niklaswa/monav-display/firmware/preview/01-boot.png

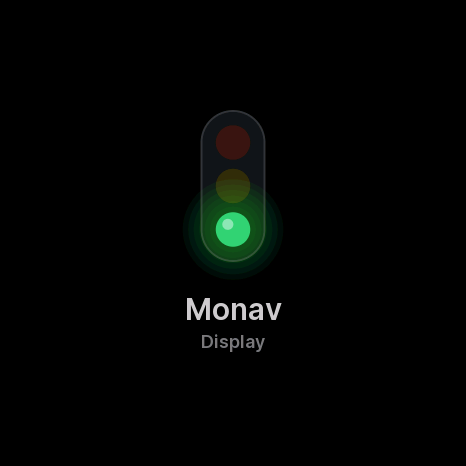
firmware/preview/01-boot.png
