niklaswa/monav-display/firmware/preview/03-waiting.png

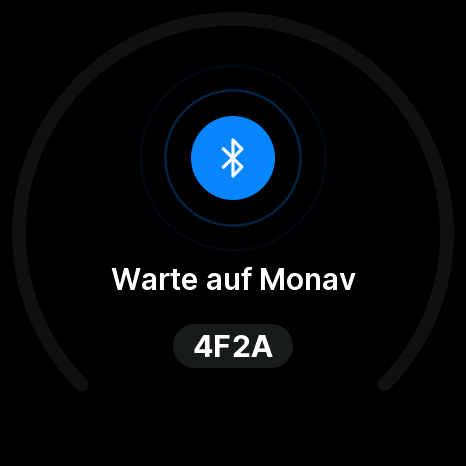
firmware/preview/03-waiting.png
