niklaswa/monav-display/firmware/preview/04-paired.png

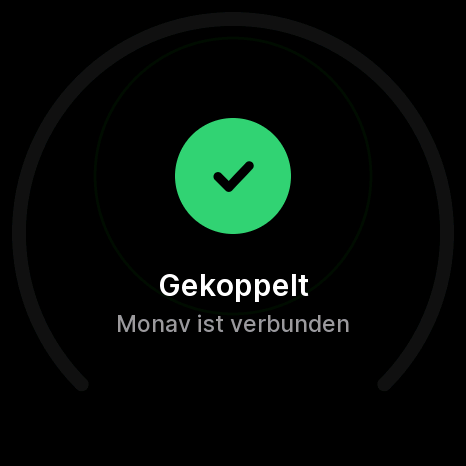
firmware/preview/04-paired.png
