niklaswa/monav-display/firmware/preview/05-denied.png

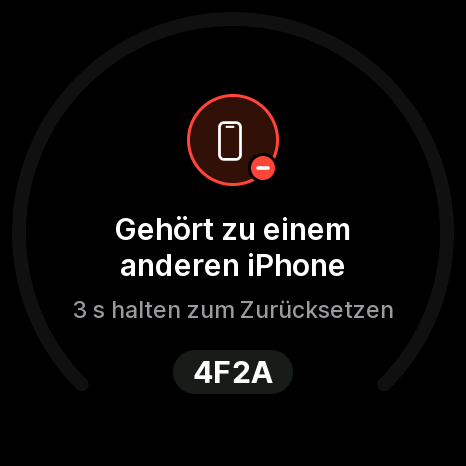
firmware/preview/05-denied.png
