niklaswa/monav-display/firmware/preview/06-connected.png

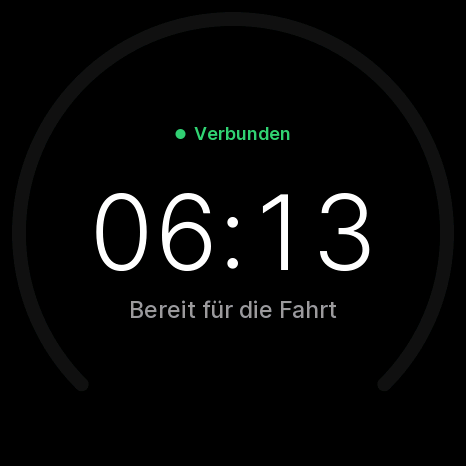
firmware/preview/06-connected.png
