niklaswa/monav-display/firmware/preview/07-camera-too-fast.png

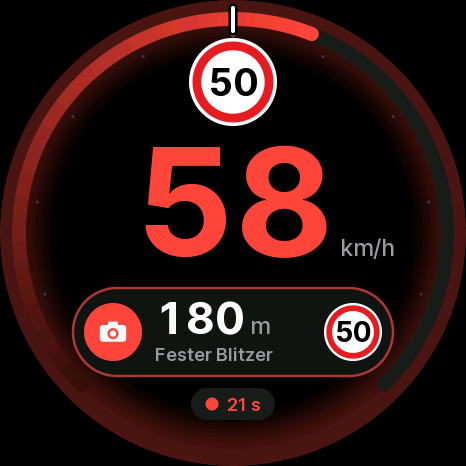
firmware/preview/07-camera-too-fast.png
