niklaswa/monav-display/firmware/preview/10-light-coast.png

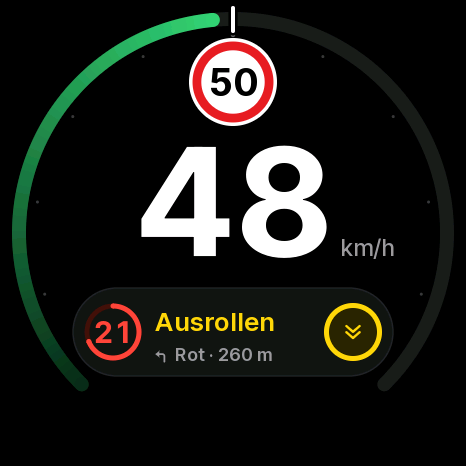
firmware/preview/10-light-coast.png
