niklaswa/monav-display/firmware/preview/11-light-standing.png

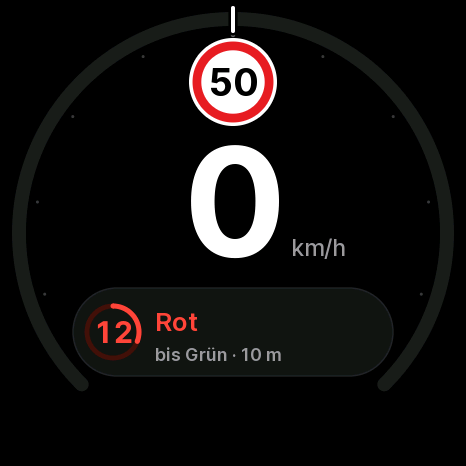
firmware/preview/11-light-standing.png
