niklaswa/monav-display/firmware/preview/12-turn.png

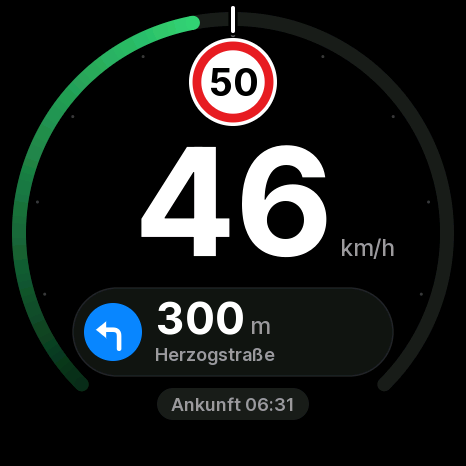
firmware/preview/12-turn.png
