niklaswa/monav-display/firmware/preview/15-highway-mobile.png

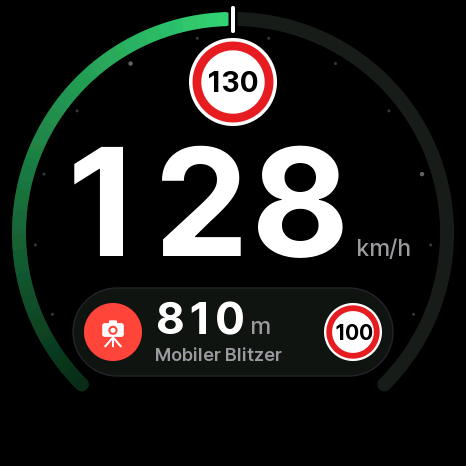
firmware/preview/15-highway-mobile.png
