niklaswa/monav-display/firmware/preview/17-no-limit.png

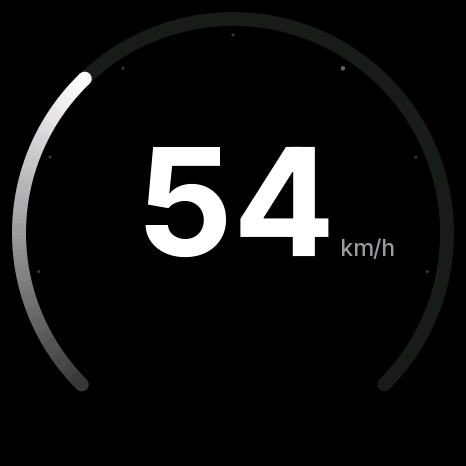
firmware/preview/17-no-limit.png
