niklaswa/monav-display/firmware/preview/18-link-lost.png

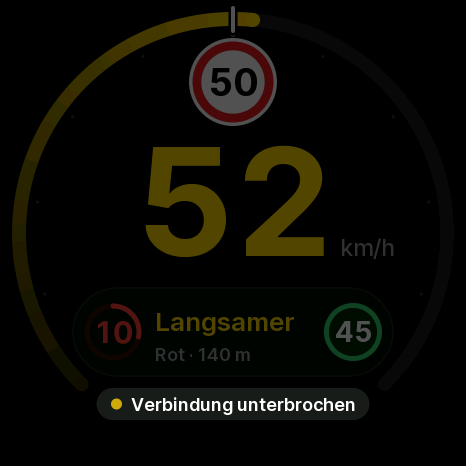
firmware/preview/18-link-lost.png
