niklaswa/monav-display/firmware/preview/20-reset-ask.png

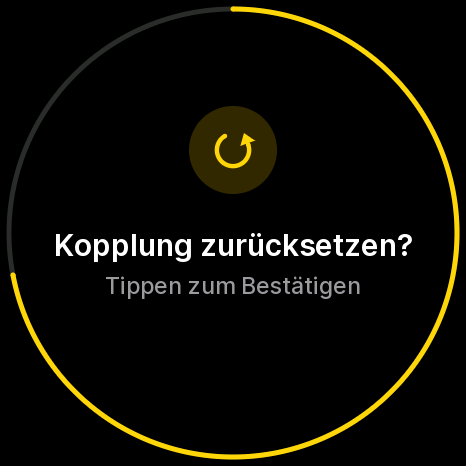
firmware/preview/20-reset-ask.png
