niklaswa/monav-display/firmware/preview/21-brightness.png

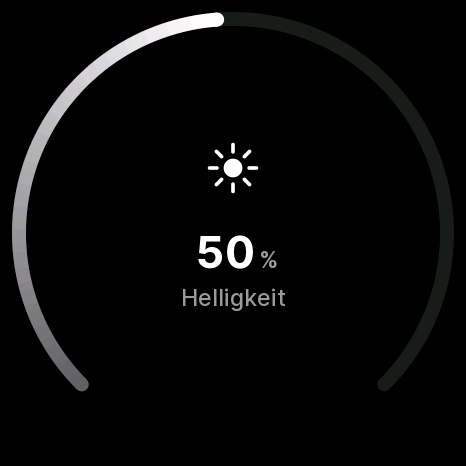
firmware/preview/21-brightness.png
