niklaswa/monav-display/firmware/preview/23-english-light.png

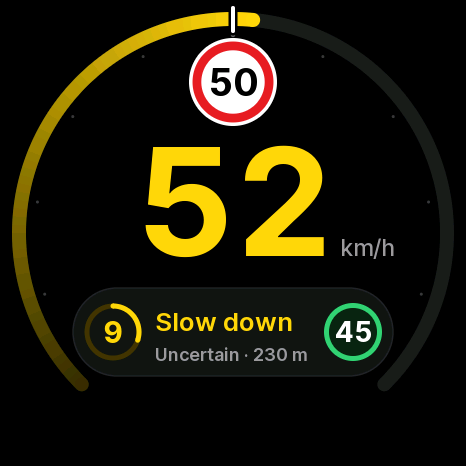
firmware/preview/23-english-light.png
