niklaswa/monav-display/firmware/preview/27-map-camera.png

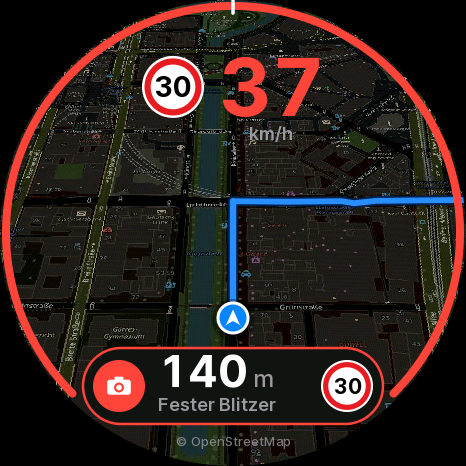
firmware/preview/27-map-camera.png
