niklaswa/monav-display/firmware/preview/29-map-english.png

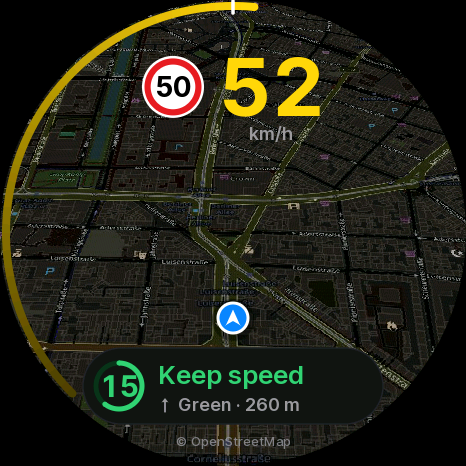
firmware/preview/29-map-english.png
