niklaswa/monav-display/firmware/preview/30-map-loading.png

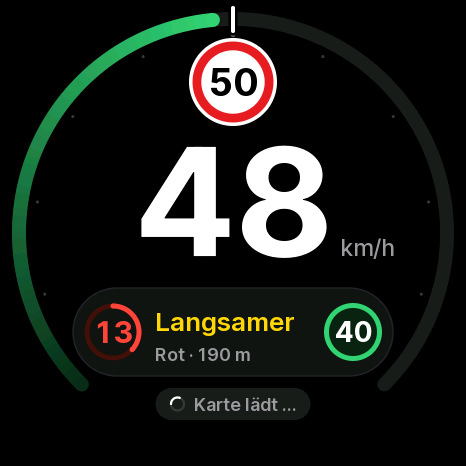
firmware/preview/30-map-loading.png
