niklaswa/monav-display/firmware/preview/32-update-restart.png

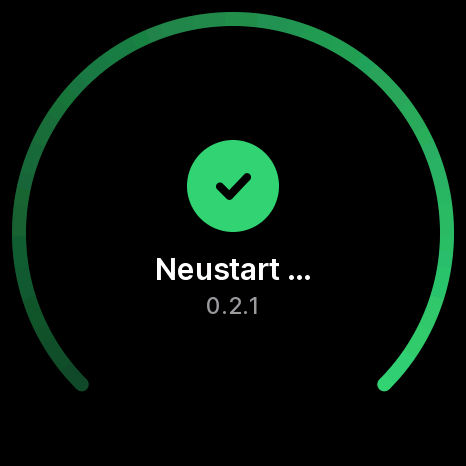
firmware/preview/32-update-restart.png
