niklaswa/monav-display/firmware/preview/33-update-failed.png

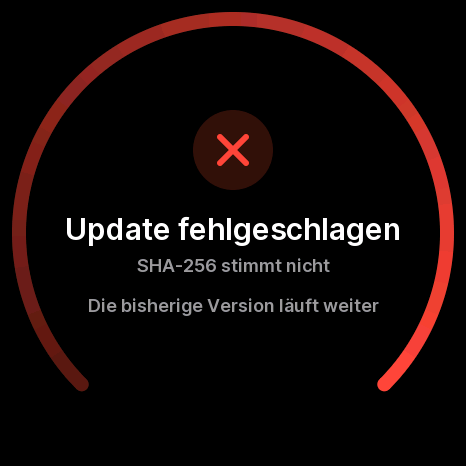
firmware/preview/33-update-failed.png
