niklaswa/monav-display/firmware/preview/34-rotated.png

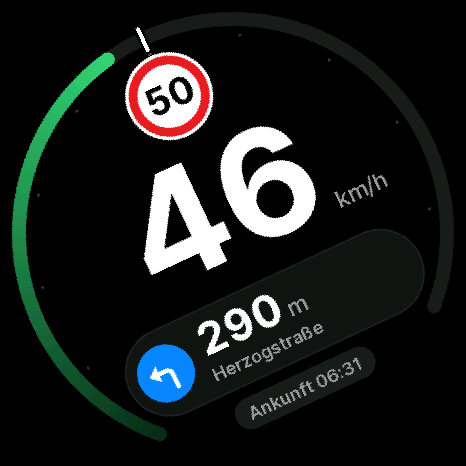
firmware/preview/34-rotated.png
