niklaswa/monav-display/firmware/preview/35-map-chargers.png

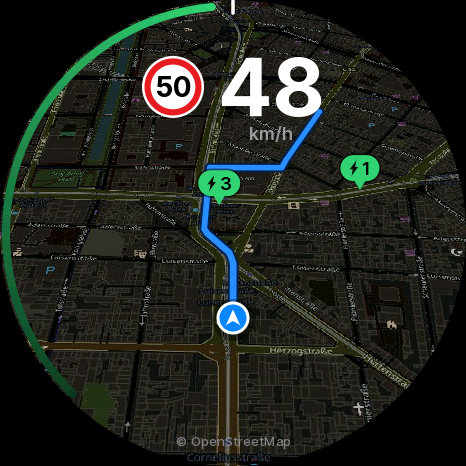
firmware/preview/35-map-chargers.png
