niklaswa/monav-display/firmware/tools/preview/maps/sample-a46.jpg

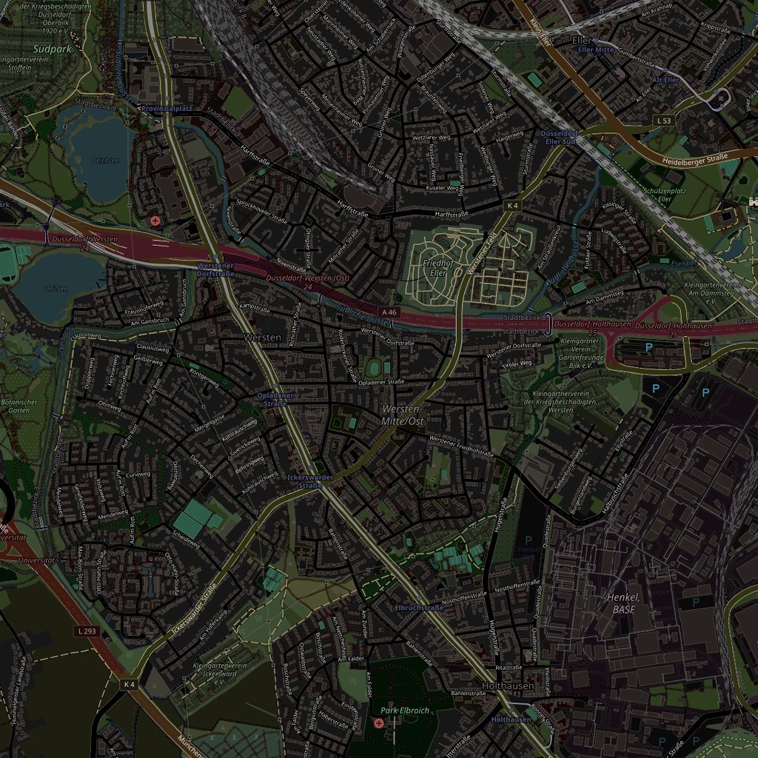
firmware/tools/preview/maps/sample-a46.jpg
