niklaswa/monav-display/firmware/tools/preview/maps/sample-berliner-allee.jpg

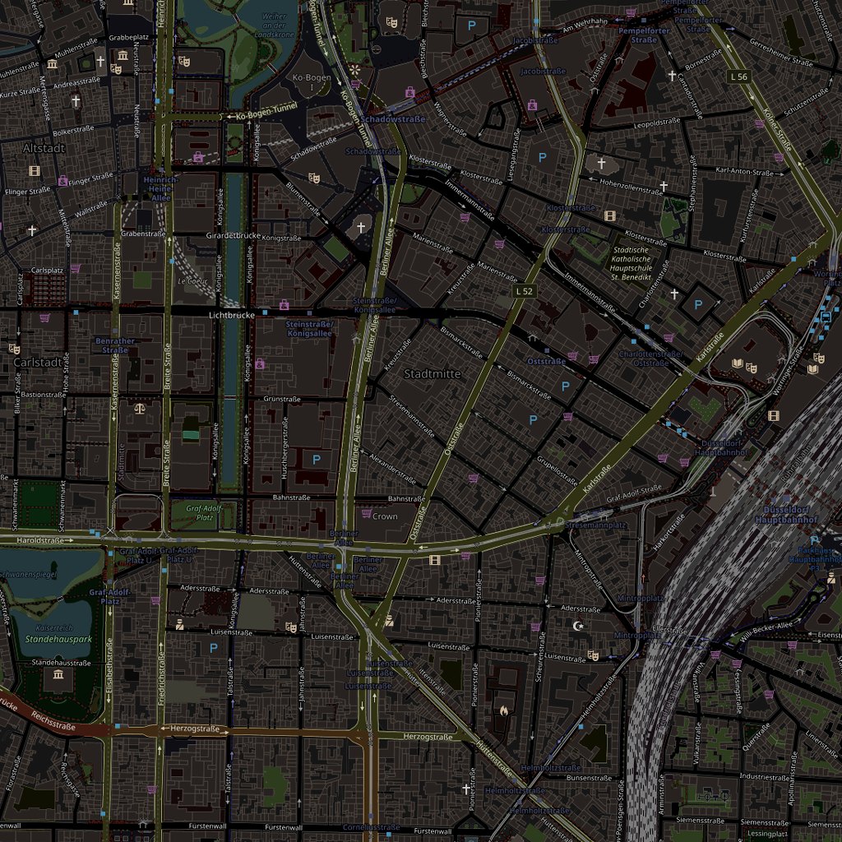
firmware/tools/preview/maps/sample-berliner-allee.jpg
