niklaswa/monav-display/firmware/tools/preview/maps/sample-koenigsallee.jpg

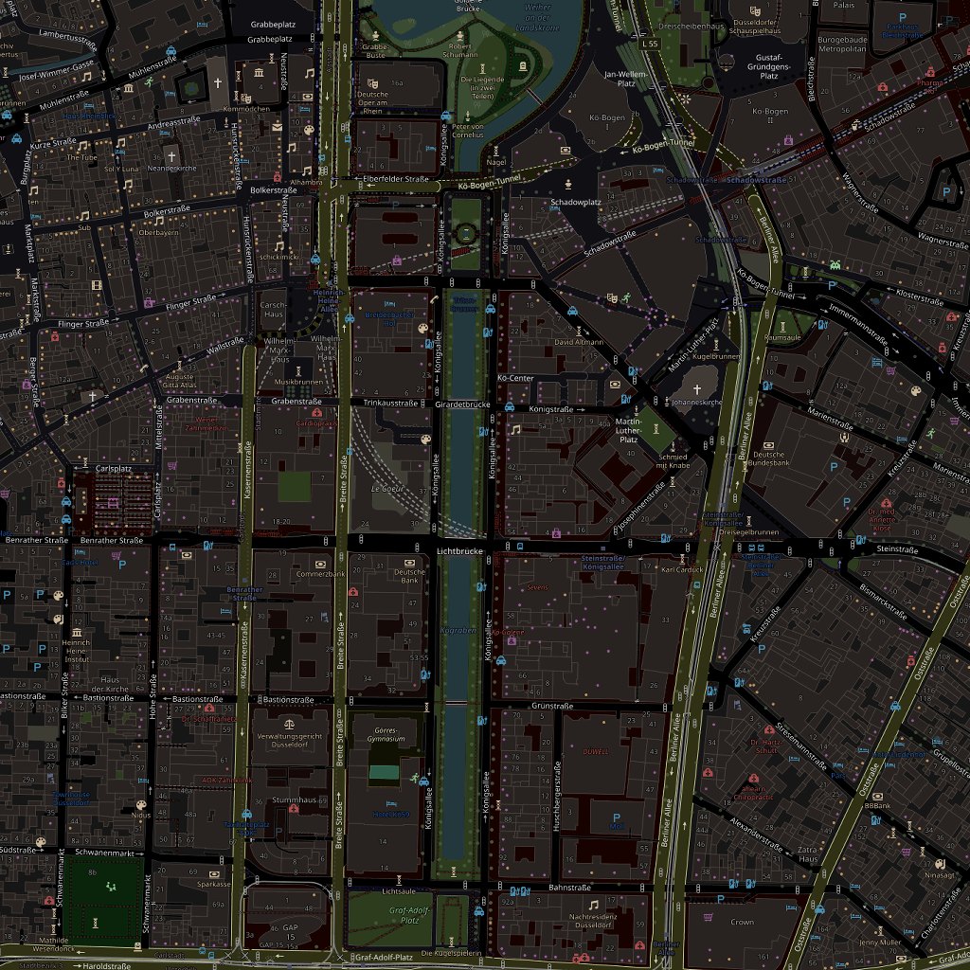
firmware/tools/preview/maps/sample-koenigsallee.jpg
