niklaswa/monav-display/mount/monav-socket.3mf

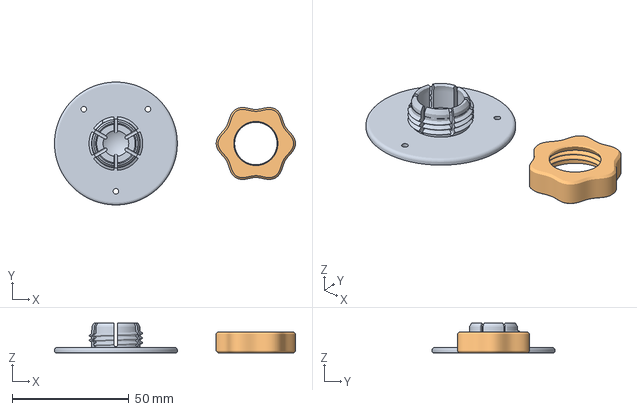
[picture p40: CAD file, 2026-11-01]
mount/monav-socket.3mf
103.3 x 52.7 x 12.8 mm
monav-lid
monav-nut
