niklaswa/monav-display/mount/monav-mount.3mf

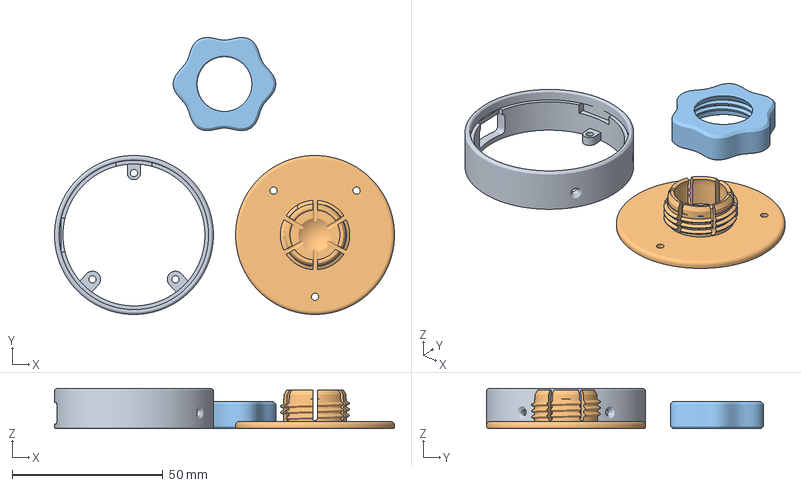
[picture p41: CAD file, 2026-11-01]
mount/monav-mount.3mf
112.7 x 91.7 x 13.4 mm
monav-ring
monav-lid
monav-nut
