niklaswa/monav-display/mount/stl/monav-ring.stl

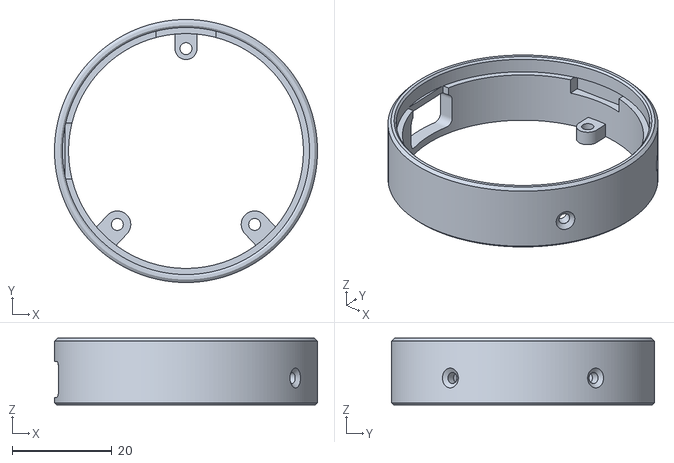
[picture p42: CAD file, 2026-11-01]
mount/stl/monav-ring.stl
52.7 x 52.7 x 13.4
