niklaswa/monav-display/mount/monav-test.3mf

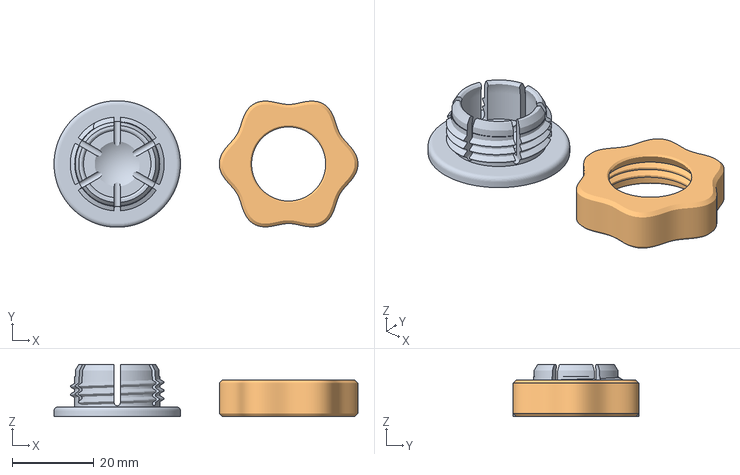
[picture p43: CAD file, 2026-11-01]
mount/monav-test.3mf
74.5 x 31.0 x 12.8 mm
monav-test_socket
monav-nut
