niklaswa/monav-display/mount/stl/monav-lid.stl

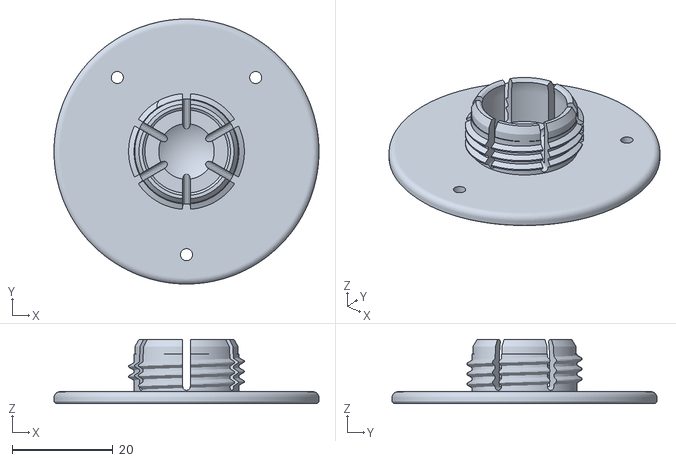
[picture p44: CAD file, 2026-11-01]
mount/stl/monav-lid.stl
52.7 x 52.7 x 12.8
