niklaswa/monav-display/mount/stl/monav-test_socket.stl

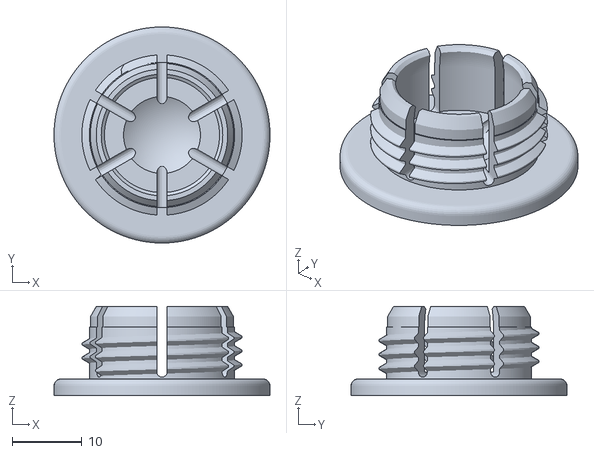
[picture p45: CAD file, 2026-11-01]
mount/stl/monav-test_socket.stl
31.0 x 31.0 x 12.8
