niklaswa/monav-display/mount/stl/monav-nut.stl

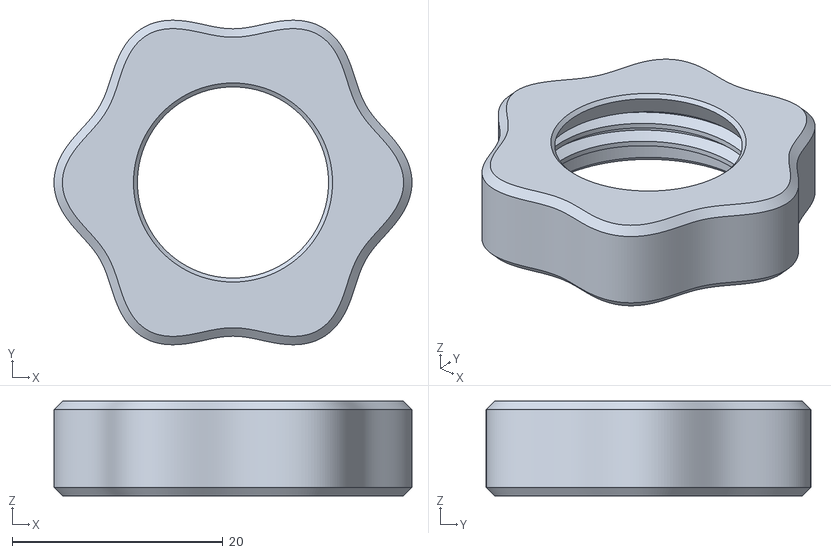
[picture p46: CAD file, 2026-11-01]
mount/stl/monav-nut.stl
34.0 x 30.8 x 9.01
