niklaswa/monav-display/mount/board_dummy.scad

// Generated from Waveshare's STEP model (ESP32-S3-Touch-AMOLED-1_75.stp): per-part bounding
// boxes in the mount's frame. X/Y as seen from behind, Z = depth behind the glass front.
// Round parts are modelled as cylinders, the two side switches as rotated boxes. Boxes are
// clipped to the PCB outline (rotated parts' boxes would poke past it), except the USB-C port,
// which really does stand 0.8 mm proud of the edge.
module board_dummy() {
    color("#111") translate([0, 0, 0]) cylinder(d = 48.96, h = 2.05);          // cover glass + panel
    color("#333") translate([0, 0, 2.05]) cylinder(d = 41.8, h = 1.35);        // panel back
    color("#c07020") intersection() { cylinder(r = 24.55, h = 3); translate([-4.65, -24.55, 2.05]) cube([9.3, 1.75, 0.70]); }  // panel flex cable folding round the edge
    color("#c07020") translate([-3.65, 23.3, 2.05]) cube([7.3, 0.7, 0.15]);     // panel tabs
    color("#ccc", 0.6) translate([0, 0, 2.05]) cylinder(d = 45.66, h = 3.65);  // PMMA spacer
    color("#1d4fa0") translate([0, 0, 5.70]) cylinder(d = 46.02, h = 1.20);    // PCB
    for (a = [33.6, -33.6]) rotate(a) {                                           // KEY1 (BOOT, +) / KEY2 (PWR, -)
        color("#888") translate([19.1, -2.3, 6.5]) cube([2.9, 4.6, 2.2]);
        color("#eee") translate([22.0, -0.9, 7.3]) cube([0.8, 2.0, 1.0]);
    }
    color("#444") intersection() { cylinder(r = 23.01, h = 20); translate([2.670, -20.120, 6.900]) cube([7.650, 4.200, 4.800]); }  // H3_ASM
    color("#444") intersection() { cylinder(r = 23.01, h = 20); translate([14.060, -7.630, 6.900]) cube([0.300, 0.490, 0.310]); }  // USER_LIBRARY-0201_0603M__CAP_ASM
    color("#444") intersection() { cylinder(r = 23.01, h = 20); translate([14.060, -7.690, 6.900]) cube([0.300, 0.060, 0.300]); }  // USER_LIBRARY-0201_0603M__CAP_ASM
    color("#444") intersection() { cylinder(r = 23.01, h = 20); translate([14.060, -7.140, 6.900]) cube([0.300, 0.060, 0.300]); }  // USER_LIBRARY-0201_0603M__CAP_ASM
    color("#444") intersection() { cylinder(r = 23.01, h = 20); translate([14.960, -7.630, 6.900]) cube([0.300, 0.490, 0.310]); }  // USER_LIBRARY-0201_0603M__CAP_ASM
    color("#444") intersection() { cylinder(r = 23.01, h = 20); translate([14.960, -7.690, 6.900]) cube([0.300, 0.060, 0.300]); }  // USER_LIBRARY-0201_0603M__CAP_ASM
    color("#444") intersection() { cylinder(r = 23.01, h = 20); translate([14.960, -7.140, 6.900]) cube([0.300, 0.060, 0.300]); }  // USER_LIBRARY-0201_0603M__CAP_ASM
    color("#444") intersection() { cylinder(r = 23.01, h = 20); translate([8.860, 2.920, 6.900]) cube([0.300, 0.480, 0.310]); }  // USER_LIBRARY-0201_0603M__CAP_ASM
    color("#444") intersection() { cylinder(r = 23.01, h = 20); translate([8.860, 3.400, 6.900]) cube([0.300, 0.060, 0.300]); }  // USER_LIBRARY-0201_0603M__CAP_ASM
    color("#444") intersection() { cylinder(r = 23.01, h = 20); translate([8.860, 2.860, 6.900]) cube([0.300, 0.060, 0.300]); }  // USER_LIBRARY-0201_0603M__CAP_ASM
    color("#444") intersection() { cylinder(r = 23.01, h = 20); translate([15.450, -4.800, 6.900]) cube([0.300, 0.490, 0.310]); }  // USER_LIBRARY-0201_0603M__CAP_ASM
    color("#444") intersection() { cylinder(r = 23.01, h = 20); translate([15.450, -4.860, 6.900]) cube([0.300, 0.060, 0.300]); }  // USER_LIBRARY-0201_0603M__CAP_ASM
    color("#444") intersection() { cylinder(r = 23.01, h = 20); translate([15.450, -4.310, 6.900]) cube([0.300, 0.060, 0.300]); }  // USER_LIBRARY-0201_0603M__CAP_ASM
    color("#444") intersection() { cylinder(r = 23.01, h = 20); translate([12.910, -4.800, 6.900]) cube([0.300, 0.490, 0.310]); }  // USER_LIBRARY-0201_0603M__CAP_ASM
    color("#444") intersection() { cylinder(r = 23.01, h = 20); translate([12.910, -4.860, 6.900]) cube([0.300, 0.060, 0.300]); }  // USER_LIBRARY-0201_0603M__CAP_ASM
    color("#444") intersection() { cylinder(r = 23.01, h = 20); translate([12.910, -4.310, 6.900]) cube([0.300, 0.060, 0.300]); }  // USER_LIBRARY-0201_0603M__CAP_ASM
    color("#444") intersection() { cylinder(r = 23.01, h = 20); translate([14.090, -9.540, 6.900]) cube([0.300, 0.490, 0.310]); }  // USER_LIBRARY-0201_0603M__CAP_ASM
    color("#444") intersection() { cylinder(r = 23.01, h = 20); translate([14.090, -9.600, 6.900]) cube([0.300, 0.060, 0.300]); }  // USER_LIBRARY-0201_0603M__CAP_ASM
    color("#444") intersection() { cylinder(r = 23.01, h = 20); translate([14.090, -9.050, 6.900]) cube([0.300, 0.060, 0.300]); }  // USER_LIBRARY-0201_0603M__CAP_ASM
    color("#444") intersection() { cylinder(r = 23.01, h = 20); translate([16.590, -6.320, 6.900]) cube([0.300, 0.480, 0.310]); }  // USER_LIBRARY-0201_0603M__CAP_ASM
    color("#444") intersection() { cylinder(r = 23.01, h = 20); translate([16.590, -6.380, 6.900]) cube([0.300, 0.060, 0.300]); }  // USER_LIBRARY-0201_0603M__CAP_ASM
    color("#444") intersection() { cylinder(r = 23.01, h = 20); translate([16.590, -5.840, 6.900]) cube([0.300, 0.070, 0.300]); }  // USER_LIBRARY-0201_0603M__CAP_ASM
    color("#444") intersection() { cylinder(r = 23.01, h = 20); translate([9.520, -9.540, 6.900]) cube([0.310, 0.490, 0.310]); }  // USER_LIBRARY-0201_0603M__CAP_ASM
    color("#444") intersection() { cylinder(r = 23.01, h = 20); translate([9.520, -9.600, 6.900]) cube([0.310, 0.060, 0.300]); }  // USER_LIBRARY-0201_0603M__CAP_ASM
    color("#444") intersection() { cylinder(r = 23.01, h = 20); translate([9.520, -9.050, 6.900]) cube([0.310, 0.060, 0.300]); }  // USER_LIBRARY-0201_0603M__CAP_ASM
    color("#444") intersection() { cylinder(r = 23.01, h = 20); translate([7.760, -9.540, 6.900]) cube([0.300, 0.490, 0.310]); }  // USER_LIBRARY-0201_0603M__CAP_ASM
    color("#444") intersection() { cylinder(r = 23.01, h = 20); translate([7.760, -9.600, 6.900]) cube([0.300, 0.060, 0.300]); }  // USER_LIBRARY-0201_0603M__CAP_ASM
    color("#444") intersection() { cylinder(r = 23.01, h = 20); translate([7.760, -9.050, 6.900]) cube([0.300, 0.060, 0.300]); }  // USER_LIBRARY-0201_0603M__CAP_ASM
    color("#444") intersection() { cylinder(r = 23.01, h = 20); translate([14.220, 7.880, 6.900]) cube([0.480, 0.300, 0.310]); }  // USER_LIBRARY-0201_0603M__CAP_ASM
    color("#444") intersection() { cylinder(r = 23.01, h = 20); translate([14.160, 7.880, 6.900]) cube([0.060, 0.300, 0.300]); }  // USER_LIBRARY-0201_0603M__CAP_ASM
    color("#444") intersection() { cylinder(r = 23.01, h = 20); translate([14.700, 7.880, 6.900]) cube([0.070, 0.300, 0.300]); }  // USER_LIBRARY-0201_0603M__CAP_ASM
    color("#444") intersection() { cylinder(r = 23.01, h = 20); translate([12.290, 7.880, 6.900]) cube([0.480, 0.300, 0.310]); }  // USER_LIBRARY-0201_0603M__CAP_ASM
    color("#444") intersection() { cylinder(r = 23.01, h = 20); translate([12.770, 7.880, 6.900]) cube([0.070, 0.300, 0.300]); }  // USER_LIBRARY-0201_0603M__CAP_ASM
    color("#444") intersection() { cylinder(r = 23.01, h = 20); translate([12.230, 7.880, 6.900]) cube([0.060, 0.300, 0.300]); }  // USER_LIBRARY-0201_0603M__CAP_ASM
    color("#444") intersection() { cylinder(r = 23.01, h = 20); translate([14.090, 0.770, 6.900]) cube([0.480, 0.310, 0.310]); }  // USER_LIBRARY-0201_0603M__CAP_ASM
    color("#444") intersection() { cylinder(r = 23.01, h = 20); translate([14.570, 0.770, 6.900]) cube([0.070, 0.310, 0.300]); }  // USER_LIBRARY-0201_0603M__CAP_ASM
    color("#444") intersection() { cylinder(r = 23.01, h = 20); translate([14.030, 0.770, 6.900]) cube([0.060, 0.310, 0.300]); }  // USER_LIBRARY-0201_0603M__CAP_ASM
    color("#444") intersection() { cylinder(r = 23.01, h = 20); translate([8.590, -9.540, 6.900]) cube([0.300, 0.490, 0.310]); }  // USER_LIBRARY-0201_0603M__CAP_ASM
    color("#444") intersection() { cylinder(r = 23.01, h = 20); translate([8.590, -9.050, 6.900]) cube([0.300, 0.060, 0.300]); }  // USER_LIBRARY-0201_0603M__CAP_ASM
    color("#444") intersection() { cylinder(r = 23.01, h = 20); translate([8.590, -9.600, 6.900]) cube([0.300, 0.060, 0.300]); }  // USER_LIBRARY-0201_0603M__CAP_ASM
    color("#444") intersection() { cylinder(r = 23.01, h = 20); translate([14.090, -0.060, 6.900]) cube([0.480, 0.300, 0.310]); }  // USER_LIBRARY-0201_0603M__CAP_ASM
    color("#444") intersection() { cylinder(r = 23.01, h = 20); translate([14.570, -0.060, 6.900]) cube([0.070, 0.300, 0.300]); }  // USER_LIBRARY-0201_0603M__CAP_ASM
    color("#444") intersection() { cylinder(r = 23.01, h = 20); translate([14.030, -0.060, 6.900]) cube([0.060, 0.300, 0.300]); }  // USER_LIBRARY-0201_0603M__CAP_ASM
    color("#444") intersection() { cylinder(r = 23.01, h = 20); translate([14.030, -1.110, 6.930]) cube([0.600, 0.500, 0.500]); }  // _1_10001
    color("#444") intersection() { cylinder(r = 23.01, h = 20); translate([12.960, -2.550, 6.920]) cube([2.390, 2.600, 0.520]); }  // C_0402-672_AF0_ASM_ASM
    color("#444") intersection() { cylinder(r = 23.01, h = 20); translate([14.630, -1.120, 6.920]) cube([0.200, 0.520, 0.520]); }  // 2_100
    color("#444") intersection() { cylinder(r = 23.01, h = 20); translate([14.090, -3.160, 6.900]) cube([0.490, 0.300, 0.310]); }  // USER_LIBRARY-0201_0603M__CAP_ASM
    color("#444") intersection() { cylinder(r = 23.01, h = 20); translate([14.030, -3.160, 6.900]) cube([0.060, 0.300, 0.300]); }  // USER_LIBRARY-0201_0603M__CAP_ASM
    color("#444") intersection() { cylinder(r = 23.01, h = 20); translate([14.580, -3.160, 6.900]) cube([0.060, 0.300, 0.300]); }  // USER_LIBRARY-0201_0603M__CAP_ASM
    color("#444") intersection() { cylinder(r = 23.01, h = 20); translate([14.220, 9.550, 6.900]) cube([0.480, 0.310, 0.310]); }  // USER_LIBRARY-0201_0603M__CAP_ASM
    color("#444") intersection() { cylinder(r = 23.01, h = 20); translate([14.160, 9.550, 6.900]) cube([0.060, 0.310, 0.300]); }  // USER_LIBRARY-0201_0603M__CAP_ASM
    color("#444") intersection() { cylinder(r = 23.01, h = 20); translate([14.700, 9.550, 6.900]) cube([0.070, 0.310, 0.300]); }  // USER_LIBRARY-0201_0603M__CAP_ASM
    color("#444") intersection() { cylinder(r = 23.01, h = 20); translate([10.680, 12.280, 6.900]) cube([0.300, 0.490, 0.310]); }  // USER_LIBRARY-0201_0603M__CAP_ASM
    color("#444") intersection() { cylinder(r = 23.01, h = 20); translate([10.680, 12.770, 6.900]) cube([0.300, 0.060, 0.300]); }  // USER_LIBRARY-0201_0603M__CAP_ASM
    color("#444") intersection() { cylinder(r = 23.01, h = 20); translate([10.680, 12.220, 6.900]) cube([0.300, 0.060, 0.300]); }  // USER_LIBRARY-0201_0603M__CAP_ASM
    color("#444") intersection() { cylinder(r = 23.01, h = 20); translate([10.670, 13.630, 6.900]) cube([0.310, 0.490, 0.310]); }  // USER_LIBRARY-0201_0603M__CAP_ASM
    color("#444") intersection() { cylinder(r = 23.01, h = 20); translate([10.680, 13.570, 6.900]) cube([0.300, 0.060, 0.300]); }  // USER_LIBRARY-0201_0603M__CAP_ASM
    color("#444") intersection() { cylinder(r = 23.01, h = 20); translate([10.670, 14.120, 6.900]) cube([0.310, 0.060, 0.300]); }  // USER_LIBRARY-0201_0603M__CAP_ASM
    color("#444") intersection() { cylinder(r = 23.01, h = 20); translate([-8.720, 11.350, 6.900]) cube([0.300, 0.490, 0.310]); }  // USER_LIBRARY-0201_0603M__CAP_ASM
    color("#444") intersection() { cylinder(r = 23.01, h = 20); translate([-8.720, 11.290, 6.900]) cube([0.300, 0.060, 0.300]); }  // USER_LIBRARY-0201_0603M__CAP_ASM
    color("#444") intersection() { cylinder(r = 23.01, h = 20); translate([-8.720, 11.840, 6.900]) cube([0.300, 0.060, 0.300]); }  // USER_LIBRARY-0201_0603M__CAP_ASM
    color("#444") intersection() { cylinder(r = 23.01, h = 20); translate([-5.950, 13.290, 6.900]) cube([0.490, 0.310, 0.310]); }  // USER_LIBRARY-0201_0603M__CAP_ASM
    color("#444") intersection() { cylinder(r = 23.01, h = 20); translate([-5.460, 13.290, 6.900]) cube([0.060, 0.310, 0.300]); }  // USER_LIBRARY-0201_0603M__CAP_ASM
    color("#444") intersection() { cylinder(r = 23.01, h = 20); translate([-6.010, 13.290, 6.900]) cube([0.060, 0.310, 0.300]); }  // USER_LIBRARY-0201_0603M__CAP_ASM
    color("#444") intersection() { cylinder(r = 23.01, h = 20); translate([-4.530, 13.290, 6.900]) cube([0.490, 0.310, 0.310]); }  // USER_LIBRARY-0201_0603M__CAP_ASM
    color("#444") intersection() { cylinder(r = 23.01, h = 20); translate([-4.590, 13.290, 6.900]) cube([0.060, 0.310, 0.300]); }  // USER_LIBRARY-0201_0603M__CAP_ASM
    color("#444") intersection() { cylinder(r = 23.01, h = 20); translate([-4.040, 13.290, 6.900]) cube([0.060, 0.310, 0.300]); }  // USER_LIBRARY-0201_0603M__CAP_ASM
    color("#444") intersection() { cylinder(r = 23.01, h = 20); translate([-5.100, 11.170, 6.900]) cube([0.490, 0.300, 0.310]); }  // USER_LIBRARY-0201_0603M__CAP_ASM
    color("#444") intersection() { cylinder(r = 23.01, h = 20); translate([-4.610, 11.170, 6.900]) cube([0.060, 0.300, 0.300]); }  // USER_LIBRARY-0201_0603M__CAP_ASM
    color("#444") intersection() { cylinder(r = 23.01, h = 20); translate([-5.160, 11.170, 6.900]) cube([0.060, 0.300, 0.300]); }  // USER_LIBRARY-0201_0603M__CAP_ASM
    color("#444") intersection() { cylinder(r = 23.01, h = 20); translate([-18.680, 6.260, 6.900]) cube([0.310, 0.490, 0.310]); }  // USER_LIBRARY-0201_0603M__CAP_ASM
    color("#444") intersection() { cylinder(r = 23.01, h = 20); translate([-18.680, 6.200, 6.900]) cube([0.310, 0.060, 0.300]); }  // USER_LIBRARY-0201_0603M__CAP_ASM
    color("#444") intersection() { cylinder(r = 23.01, h = 20); translate([-18.680, 6.750, 6.900]) cube([0.310, 0.060, 0.300]); }  // USER_LIBRARY-0201_0603M__CAP_ASM
    color("#444") intersection() { cylinder(r = 23.01, h = 20); translate([-18.670, 7.570, 6.900]) cube([0.300, 0.490, 0.310]); }  // USER_LIBRARY-0201_0603M__CAP_ASM
    color("#444") intersection() { cylinder(r = 23.01, h = 20); translate([-18.670, 7.510, 6.900]) cube([0.300, 0.060, 0.300]); }  // USER_LIBRARY-0201_0603M__CAP_ASM
    color("#444") intersection() { cylinder(r = 23.01, h = 20); translate([-18.670, 8.060, 6.900]) cube([0.300, 0.060, 0.300]); }  // USER_LIBRARY-0201_0603M__CAP_ASM
    color("#444") intersection() { cylinder(r = 23.01, h = 20); translate([2.040, -13.040, 6.930]) cube([0.600, 0.500, 0.500]); }  // _1_10001
    color("#444") intersection() { cylinder(r = 23.01, h = 20); translate([1.320, -13.700, 6.920]) cube([2.390, 2.600, 0.520]); }  // C_0402-672_AF0_ASM_ASM
    color("#444") intersection() { cylinder(r = 23.01, h = 20); translate([1.840, -13.050, 6.920]) cube([0.200, 0.520, 0.520]); }  // 2_100
    color("#444") intersection() { cylinder(r = 23.01, h = 20); translate([0.580, -8.310, 6.900]) cube([0.480, 0.300, 0.310]); }  // USER_LIBRARY-0201_0603M__CAP_ASM
    color("#444") intersection() { cylinder(r = 23.01, h = 20); translate([1.060, -8.310, 6.900]) cube([0.060, 0.300, 0.300]); }  // USER_LIBRARY-0201_0603M__CAP_ASM
    color("#444") intersection() { cylinder(r = 23.01, h = 20); translate([0.510, -8.310, 6.900]) cube([0.070, 0.300, 0.300]); }  // USER_LIBRARY-0201_0603M__CAP_ASM
    color("#444") intersection() { cylinder(r = 23.01, h = 20); translate([0.950, -9.520, 6.900]) cube([0.310, 0.480, 0.310]); }  // USER_LIBRARY-0201_0603M__CAP_ASM
    color("#444") intersection() { cylinder(r = 23.01, h = 20); translate([0.950, -9.040, 6.900]) cube([0.310, 0.060, 0.300]); }  // USER_LIBRARY-0201_0603M__CAP_ASM
    color("#444") intersection() { cylinder(r = 23.01, h = 20); translate([0.950, -9.590, 6.900]) cube([0.310, 0.070, 0.300]); }  // USER_LIBRARY-0201_0603M__CAP_ASM
    color("#444") intersection() { cylinder(r = 23.01, h = 20); translate([-0.300, -17.600, 6.930]) cube([0.600, 0.500, 0.500]); }  // _1_10001
    color("#444") intersection() { cylinder(r = 23.01, h = 20); translate([-1.020, -18.260, 6.920]) cube([2.390, 2.600, 0.520]); }  // C_0402-672_AF0_ASM_ASM
    color("#444") intersection() { cylinder(r = 23.01, h = 20); translate([-0.500, -17.610, 6.920]) cube([0.200, 0.520, 0.520]); }  // 2_100
    color("#444") intersection() { cylinder(r = 23.01, h = 20); translate([-3.040, -13.040, 6.930]) cube([0.600, 0.500, 0.500]); }  // _1_10001
    color("#444") intersection() { cylinder(r = 23.01, h = 20); translate([-3.760, -13.700, 6.920]) cube([2.390, 2.600, 0.520]); }  // C_0402-672_AF0_ASM_ASM
    color("#444") intersection() { cylinder(r = 23.01, h = 20); translate([-3.240, -13.050, 6.920]) cube([0.200, 0.520, 0.520]); }  // 2_100
    color("#444") intersection() { cylinder(r = 23.01, h = 20); translate([-0.770, -8.310, 6.900]) cube([0.490, 0.300, 0.310]); }  // USER_LIBRARY-0201_0603M__CAP_ASM
    color("#444") intersection() { cylinder(r = 23.01, h = 20); translate([-0.280, -8.310, 6.900]) cube([0.060, 0.300, 0.300]); }  // USER_LIBRARY-0201_0603M__CAP_ASM
    color("#444") intersection() { cylinder(r = 23.01, h = 20); translate([-0.830, -8.310, 6.900]) cube([0.060, 0.300, 0.300]); }  // USER_LIBRARY-0201_0603M__CAP_ASM
    color("#444") intersection() { cylinder(r = 23.01, h = 20); translate([-0.680, -9.480, 6.900]) cube([0.310, 0.480, 0.310]); }  // USER_LIBRARY-0201_0603M__CAP_ASM
    color("#444") intersection() { cylinder(r = 23.01, h = 20); translate([-0.680, -9.000, 6.900]) cube([0.310, 0.060, 0.300]); }  // USER_LIBRARY-0201_0603M__CAP_ASM
    color("#444") intersection() { cylinder(r = 23.01, h = 20); translate([-0.680, -9.550, 6.900]) cube([0.310, 0.070, 0.300]); }  // USER_LIBRARY-0201_0603M__CAP_ASM
    color("#444") intersection() { cylinder(r = 23.01, h = 20); translate([-14.110, -7.770, 6.900]) cube([0.310, 0.490, 0.310]); }  // USER_LIBRARY-0201_0603M__CAP_ASM
    color("#444") intersection() { cylinder(r = 23.01, h = 20); translate([-14.110, -7.280, 6.900]) cube([0.310, 0.060, 0.300]); }  // USER_LIBRARY-0201_0603M__CAP_ASM
    color("#444") intersection() { cylinder(r = 23.01, h = 20); translate([-14.110, -7.830, 6.900]) cube([0.310, 0.060, 0.300]); }  // USER_LIBRARY-0201_0603M__CAP_ASM
    color("#444") intersection() { cylinder(r = 23.01, h = 20); translate([-14.110, -6.270, 6.900]) cube([0.300, 0.490, 0.310]); }  // USER_LIBRARY-0201_0603M__CAP_ASM
    color("#444") intersection() { cylinder(r = 23.01, h = 20); translate([-14.110, -5.780, 6.900]) cube([0.300, 0.060, 0.300]); }  // USER_LIBRARY-0201_0603M__CAP_ASM
    color("#444") intersection() { cylinder(r = 23.01, h = 20); translate([-14.110, -6.330, 6.900]) cube([0.300, 0.060, 0.300]); }  // USER_LIBRARY-0201_0603M__CAP_ASM
    color("#444") intersection() { cylinder(r = 23.01, h = 20); translate([-14.930, -6.270, 6.900]) cube([0.310, 0.490, 0.310]); }  // USER_LIBRARY-0201_0603M__CAP_ASM
    color("#444") intersection() { cylinder(r = 23.01, h = 20); translate([-14.930, -5.780, 6.900]) cube([0.310, 0.060, 0.300]); }  // USER_LIBRARY-0201_0603M__CAP_ASM
    color("#444") intersection() { cylinder(r = 23.01, h = 20); translate([-14.930, -6.330, 6.900]) cube([0.310, 0.060, 0.300]); }  // USER_LIBRARY-0201_0603M__CAP_ASM
    color("#444") intersection() { cylinder(r = 23.01, h = 20); translate([-16.560, -7.770, 6.900]) cube([0.310, 0.490, 0.310]); }  // USER_LIBRARY-0201_0603M__CAP_ASM
    color("#444") intersection() { cylinder(r = 23.01, h = 20); translate([-16.560, -7.280, 6.900]) cube([0.310, 0.060, 0.300]); }  // USER_LIBRARY-0201_0603M__CAP_ASM
    color("#444") intersection() { cylinder(r = 23.01, h = 20); translate([-16.550, -7.830, 6.900]) cube([0.300, 0.060, 0.300]); }  // USER_LIBRARY-0201_0603M__CAP_ASM
    color("#444") intersection() { cylinder(r = 23.01, h = 20); translate([-14.920, -7.770, 6.900]) cube([0.300, 0.490, 0.310]); }  // USER_LIBRARY-0201_0603M__CAP_ASM
    color("#444") intersection() { cylinder(r = 23.01, h = 20); translate([-14.920, -7.830, 6.900]) cube([0.300, 0.060, 0.300]); }  // USER_LIBRARY-0201_0603M__CAP_ASM
    color("#444") intersection() { cylinder(r = 23.01, h = 20); translate([-14.920, -7.280, 6.900]) cube([0.300, 0.060, 0.300]); }  // USER_LIBRARY-0201_0603M__CAP_ASM
    color("#444") intersection() { cylinder(r = 23.01, h = 20); translate([1.950, -9.540, 6.900]) cube([0.310, 0.490, 0.310]); }  // USER_LIBRARY-0201_0603M__CAP_ASM
    color("#444") intersection() { cylinder(r = 23.01, h = 20); translate([1.950, -9.600, 6.900]) cube([0.310, 0.060, 0.300]); }  // USER_LIBRARY-0201_0603M__CAP_ASM
    color("#444") intersection() { cylinder(r = 23.01, h = 20); translate([1.950, -9.050, 6.900]) cube([0.310, 0.060, 0.300]); }  // USER_LIBRARY-0201_0603M__CAP_ASM
    color("#444") intersection() { cylinder(r = 23.01, h = 20); translate([-12.480, -6.270, 6.900]) cube([0.310, 0.490, 0.310]); }  // USER_LIBRARY-0201_0603M__CAP_ASM
    color("#444") intersection() { cylinder(r = 23.01, h = 20); translate([-12.480, -5.780, 6.900]) cube([0.310, 0.060, 0.300]); }  // USER_LIBRARY-0201_0603M__CAP_ASM
    color("#444") intersection() { cylinder(r = 23.01, h = 20); translate([-12.480, -6.330, 6.900]) cube([0.310, 0.060, 0.300]); }  // USER_LIBRARY-0201_0603M__CAP_ASM
    color("#444") intersection() { cylinder(r = 23.01, h = 20); translate([-13.290, -6.270, 6.900]) cube([0.300, 0.490, 0.310]); }  // USER_LIBRARY-0201_0603M__CAP_ASM
    color("#444") intersection() { cylinder(r = 23.01, h = 20); translate([-13.290, -5.780, 6.900]) cube([0.300, 0.060, 0.300]); }  // USER_LIBRARY-0201_0603M__CAP_ASM
    color("#444") intersection() { cylinder(r = 23.01, h = 20); translate([-13.290, -6.330, 6.900]) cube([0.300, 0.060, 0.300]); }  // USER_LIBRARY-0201_0603M__CAP_ASM
    color("#444") intersection() { cylinder(r = 23.01, h = 20); translate([-12.470, -7.770, 6.900]) cube([0.300, 0.490, 0.310]); }  // USER_LIBRARY-0201_0603M__CAP_ASM
    color("#444") intersection() { cylinder(r = 23.01, h = 20); translate([-12.470, -7.280, 6.900]) cube([0.300, 0.060, 0.300]); }  // USER_LIBRARY-0201_0603M__CAP_ASM
    color("#444") intersection() { cylinder(r = 23.01, h = 20); translate([-12.470, -7.830, 6.900]) cube([0.300, 0.060, 0.300]); }  // USER_LIBRARY-0201_0603M__CAP_ASM
    color("#444") intersection() { cylinder(r = 23.01, h = 20); translate([-13.290, -7.770, 6.900]) cube([0.310, 0.490, 0.310]); }  // USER_LIBRARY-0201_0603M__CAP_ASM
    color("#444") intersection() { cylinder(r = 23.01, h = 20); translate([-13.290, -7.280, 6.900]) cube([0.310, 0.060, 0.300]); }  // USER_LIBRARY-0201_0603M__CAP_ASM
    color("#444") intersection() { cylinder(r = 23.01, h = 20); translate([-13.290, -7.830, 6.900]) cube([0.310, 0.060, 0.300]); }  // USER_LIBRARY-0201_0603M__CAP_ASM
    color("#444") intersection() { cylinder(r = 23.01, h = 20); translate([-12.370, -4.460, 6.920]) cube([0.300, 0.820, 0.820]); }  // 2_1_200
    color("#444") intersection() { cylinder(r = 23.01, h = 20); translate([-13.370, -4.450, 6.930]) cube([1.000, 0.800, 0.800]); }  // _1_1_20001
    color("#444") intersection() { cylinder(r = 23.01, h = 20); translate([-15.230, -7.030, 6.920]) cube([4.180, 4.540, 0.820]); }  // C_0603-683_AF0_ASM_ASM
    color("#444") intersection() { cylinder(r = 23.01, h = 20); translate([-10.430, 7.250, 6.920]) cube([0.820, 0.300, 0.820]); }  // 2_1_200
    color("#444") intersection() { cylinder(r = 23.01, h = 20); translate([-10.420, 6.250, 6.930]) cube([0.800, 1.000, 0.800]); }  // _1_1_20001
    color("#444") intersection() { cylinder(r = 23.01, h = 20); translate([-11.580, 4.390, 6.920]) cube([4.540, 4.180, 0.820]); }  // C_0603-683_AF0_ASM_ASM
    color("#444") intersection() { cylinder(r = 23.01, h = 20); translate([-8.110, -2.860, 6.900]) cube([0.490, 0.300, 0.310]); }  // USER_LIBRARY-0201_0603M__CAP_ASM
    color("#444") intersection() { cylinder(r = 23.01, h = 20); translate([-7.620, -2.860, 6.900]) cube([0.060, 0.300, 0.300]); }  // USER_LIBRARY-0201_0603M__CAP_ASM
    color("#444") intersection() { cylinder(r = 23.01, h = 20); translate([-8.170, -2.860, 6.900]) cube([0.060, 0.300, 0.300]); }  // USER_LIBRARY-0201_0603M__CAP_ASM
    color("#444") intersection() { cylinder(r = 23.01, h = 20); translate([0.160, -3.590, 6.920]) cube([0.300, 0.820, 0.820]); }  // 2_1_200
    color("#444") intersection() { cylinder(r = 23.01, h = 20); translate([-0.840, -3.580, 6.930]) cube([1.000, 0.800, 0.800]); }  // _1_1_20001
    color("#444") intersection() { cylinder(r = 23.01, h = 20); translate([-2.700, -6.160, 6.920]) cube([4.180, 4.540, 0.820]); }  // C_0603-683_AF0_ASM_ASM
    color("#444") intersection() { cylinder(r = 23.01, h = 20); translate([-10.450, 10.010, 6.920]) cube([0.820, 0.300, 0.820]); }  // 2_1_200
    color("#444") intersection() { cylinder(r = 23.01, h = 20); translate([-10.440, 9.010, 6.930]) cube([0.800, 1.000, 0.800]); }  // _1_1_20001
    color("#444") intersection() { cylinder(r = 23.01, h = 20); translate([-11.600, 7.150, 6.920]) cube([4.540, 4.190, 0.820]); }  // C_0603-683_AF0_ASM_ASM
    color("#444") intersection() { cylinder(r = 23.01, h = 20); translate([-8.720, 9.070, 6.900]) cube([0.300, 0.490, 0.310]); }  // USER_LIBRARY-0201_0603M__CAP_ASM
    color("#444") intersection() { cylinder(r = 23.01, h = 20); translate([-8.720, 9.560, 6.900]) cube([0.300, 0.060, 0.300]); }  // USER_LIBRARY-0201_0603M__CAP_ASM
    color("#444") intersection() { cylinder(r = 23.01, h = 20); translate([-8.720, 9.010, 6.900]) cube([0.300, 0.060, 0.300]); }  // USER_LIBRARY-0201_0603M__CAP_ASM
    color("#444") intersection() { cylinder(r = 23.01, h = 20); translate([-7.900, 9.080, 6.900]) cube([0.300, 0.490, 0.310]); }  // USER_LIBRARY-0201_0603M__CAP_ASM
    color("#444") intersection() { cylinder(r = 23.01, h = 20); translate([-7.900, 9.570, 6.900]) cube([0.300, 0.060, 0.300]); }  // USER_LIBRARY-0201_0603M__CAP_ASM
    color("#444") intersection() { cylinder(r = 23.01, h = 20); translate([-7.900, 9.020, 6.900]) cube([0.300, 0.060, 0.300]); }  // USER_LIBRARY-0201_0603M__CAP_ASM
    color("#444") intersection() { cylinder(r = 23.01, h = 20); translate([-3.730, 3.730, 6.900]) cube([0.490, 0.300, 0.310]); }  // USER_LIBRARY-0201_0603M__CAP_ASM
    color("#444") intersection() { cylinder(r = 23.01, h = 20); translate([-3.240, 3.730, 6.900]) cube([0.060, 0.300, 0.300]); }  // USER_LIBRARY-0201_0603M__CAP_ASM
    color("#444") intersection() { cylinder(r = 23.01, h = 20); translate([-3.790, 3.730, 6.900]) cube([0.060, 0.300, 0.300]); }  // USER_LIBRARY-0201_0603M__CAP_ASM
    color("#444") intersection() { cylinder(r = 23.01, h = 20); translate([-13.120, 1.330, 6.900]) cube([0.490, 0.300, 0.310]); }  // USER_LIBRARY-0201_0603M__CAP_ASM
    color("#444") intersection() { cylinder(r = 23.01, h = 20); translate([-12.630, 1.330, 6.900]) cube([0.060, 0.300, 0.300]); }  // USER_LIBRARY-0201_0603M__CAP_ASM
    color("#444") intersection() { cylinder(r = 23.01, h = 20); translate([-13.180, 1.330, 6.900]) cube([0.060, 0.300, 0.300]); }  // USER_LIBRARY-0201_0603M__CAP_ASM
    color("#444") intersection() { cylinder(r = 23.01, h = 20); translate([-6.350, -2.820, 6.900]) cube([0.480, 0.300, 0.310]); }  // USER_LIBRARY-0201_0603M__CAP_ASM
    color("#444") intersection() { cylinder(r = 23.01, h = 20); translate([-5.870, -2.820, 6.900]) cube([0.070, 0.300, 0.300]); }  // USER_LIBRARY-0201_0603M__CAP_ASM
    color("#444") intersection() { cylinder(r = 23.01, h = 20); translate([-6.410, -2.820, 6.900]) cube([0.060, 0.300, 0.300]); }  // USER_LIBRARY-0201_0603M__CAP_ASM
    color("#444") intersection() { cylinder(r = 23.01, h = 20); translate([-3.730, 1.920, 6.900]) cube([0.490, 0.310, 0.310]); }  // USER_LIBRARY-0201_0603M__CAP_ASM
    color("#444") intersection() { cylinder(r = 23.01, h = 20); translate([-3.790, 1.920, 6.900]) cube([0.060, 0.310, 0.300]); }  // USER_LIBRARY-0201_0603M__CAP_ASM
    color("#444") intersection() { cylinder(r = 23.01, h = 20); translate([-3.240, 1.920, 6.900]) cube([0.060, 0.310, 0.300]); }  // USER_LIBRARY-0201_0603M__CAP_ASM
    color("#444") intersection() { cylinder(r = 23.01, h = 20); translate([-3.730, 0.280, 6.900]) cube([0.490, 0.300, 0.310]); }  // USER_LIBRARY-0201_0603M__CAP_ASM
    color("#444") intersection() { cylinder(r = 23.01, h = 20); translate([-3.790, 0.280, 6.900]) cube([0.060, 0.300, 0.300]); }  // USER_LIBRARY-0201_0603M__CAP_ASM
    color("#444") intersection() { cylinder(r = 23.01, h = 20); translate([-3.240, 0.280, 6.900]) cube([0.060, 0.300, 0.300]); }  // USER_LIBRARY-0201_0603M__CAP_ASM
    color("#444") intersection() { cylinder(r = 23.01, h = 20); translate([-3.730, 2.740, 6.900]) cube([0.490, 0.310, 0.310]); }  // USER_LIBRARY-0201_0603M__CAP_ASM
    color("#444") intersection() { cylinder(r = 23.01, h = 20); translate([-3.240, 2.740, 6.900]) cube([0.060, 0.310, 0.300]); }  // USER_LIBRARY-0201_0603M__CAP_ASM
    color("#444") intersection() { cylinder(r = 23.01, h = 20); translate([-3.790, 2.740, 6.900]) cube([0.060, 0.310, 0.300]); }  // USER_LIBRARY-0201_0603M__CAP_ASM
    color("#444") intersection() { cylinder(r = 23.01, h = 20); translate([-15.070, 6.000, 6.900]) cube([3.000, 3.100, 1.250]); }  // GPS1_ASM
    color("#444") translate([-23.490, -4.430, 6.900]) cube([7.050, 8.900, 2.960]);  // 698B116-264-211_ASM
    color("#444") translate([-17.180, 2.150, 6.900]) cube([1.090, 0.260, 1.440]);  // 698B116-264-211_ASM
    color("#444") translate([-17.180, -2.370, 6.900]) cube([1.090, 0.270, 1.440]);  // 698B116-264-211_ASM
    color("#444") translate([-17.180, 1.650, 6.900]) cube([1.090, 0.250, 1.440]);  // 698B116-264-211_ASM
    color("#444") translate([-17.180, -1.850, 6.900]) cube([1.090, 0.250, 1.440]);  // 698B116-264-211_ASM
    color("#444") translate([-22.730, 0.150, 6.900]) cube([6.640, 0.250, 2.120]);  // 698B116-264-211_ASM
    color("#444") translate([-22.730, -0.350, 6.900]) cube([6.640, 0.250, 2.120]);  // 698B116-264-211_ASM
    color("#444") translate([-22.730, 0.650, 6.900]) cube([6.640, 0.250, 1.660]);  // 698B116-264-211_ASM
    color("#444") translate([-22.730, -0.850, 6.900]) cube([6.640, 0.250, 1.660]);  // 698B116-264-211_ASM
    color("#444") translate([-22.730, -0.350, 8.120]) cube([5.770, 0.250, 0.440]);  // 698B116-264-211_ASM
    color("#444") translate([-22.730, 0.150, 8.120]) cube([5.770, 0.250, 0.440]);  // 698B116-264-211_ASM
    color("#444") translate([-23.280, -3.400, 6.900]) cube([7.190, 0.850, 1.660]);  // 698B116-264-211_ASM
    color("#444") translate([-22.930, -1.530, 6.900]) cube([6.840, 0.600, 2.120]);  // 698B116-264-211_ASM
    color("#444") translate([-22.930, -1.530, 8.120]) cube([5.970, 0.600, 0.440]);  // 698B116-264-211_ASM
    color("#444") translate([-22.930, 0.970, 6.900]) cube([6.840, 0.600, 2.120]);  // 698B116-264-211_ASM
    color("#444") translate([-22.930, 0.970, 8.120]) cube([5.970, 0.600, 0.440]);  // 698B116-264-211_ASM
    color("#444") translate([-23.280, 2.600, 6.900]) cube([7.190, 0.850, 1.660]);  // 698B116-264-211_ASM
    color("#444") translate([-22.730, 0.650, 8.580]) cube([4.270, 0.250, 0.440]);  // 698B116-264-211_ASM
    color("#444") translate([-22.730, -0.850, 8.580]) cube([4.270, 0.250, 0.440]);  // 698B116-264-211_ASM
    color("#444") translate([-23.280, -3.690, 6.900]) cube([7.190, 1.300, 2.120]);  // 698B116-264-211_ASM
    color("#444") translate([-23.280, 2.430, 6.900]) cube([7.190, 1.300, 2.120]);  // 698B116-264-211_ASM
    color("#444") translate([-23.790, -5.050, 6.900]) cube([7.530, 10.140, 3.250]);  // 698B116-264-211_ASM
    color("#444") intersection() { cylinder(r = 23.01, h = 20); translate([14.530, -2.170, 6.900]) cube([0.100, 0.300, 0.280]); }  // L0201_1
    color("#444") intersection() { cylinder(r = 23.01, h = 20); translate([14.030, -2.170, 6.900]) cube([0.100, 0.300, 0.280]); }  // L0201_2
    color("#444") intersection() { cylinder(r = 23.01, h = 20); translate([14.130, -2.120, 6.950]) cube([0.400, 0.200, 0.180]); }  // L0201_3
    color("#444") intersection() { cylinder(r = 23.01, h = 20); translate([-10.630, -20.120, 6.900]) cube([7.650, 4.200, 4.800]); }  // J1_ASM
    color("#444") intersection() { cylinder(r = 23.01, h = 20); translate([19.870, -3.220, 6.930]) cube([1.980, 5.380, 0.420]); }  // 1285509552_ASM
    color("#444") intersection() { cylinder(r = 23.01, h = 20); translate([14.530, -4.420, 6.900]) cube([0.100, 0.300, 0.280]); }  // L0201_1
    color("#444") intersection() { cylinder(r = 23.01, h = 20); translate([14.030, -4.420, 6.900]) cube([0.100, 0.300, 0.280]); }  // L0201_2
    color("#444") intersection() { cylinder(r = 23.01, h = 20); translate([14.130, -4.370, 6.950]) cube([0.400, 0.200, 0.180]); }  // L0201_3
    color("#444") intersection() { cylinder(r = 23.01, h = 20); translate([16.590, -4.350, 6.900]) cube([0.300, 0.100, 0.280]); }  // L0201_1
    color("#444") intersection() { cylinder(r = 23.01, h = 20); translate([16.590, -4.850, 6.900]) cube([0.300, 0.100, 0.280]); }  // L0201_2
    color("#444") intersection() { cylinder(r = 23.01, h = 20); translate([16.640, -4.750, 6.950]) cube([0.200, 0.400, 0.180]); }  // L0201_3
    color("#444") intersection() { cylinder(r = 23.01, h = 20); translate([-7.060, 12.860, 6.900]) cube([0.300, 0.100, 0.280]); }  // L0201_1
    color("#444") intersection() { cylinder(r = 23.01, h = 20); translate([-7.060, 13.360, 6.900]) cube([0.300, 0.100, 0.280]); }  // L0201_2
    color("#444") intersection() { cylinder(r = 23.01, h = 20); translate([-7.010, 12.960, 6.950]) cube([0.200, 0.400, 0.180]); }  // L0201_3
    color("#444") intersection() { cylinder(r = 23.01, h = 20); translate([1.840, -14.070, 6.900]) cube([0.200, 0.500, 0.300]); }  // R_0402-3099_AF0_ASM_ASM
    color("#444") intersection() { cylinder(r = 23.01, h = 20); translate([-0.080, -15.790, 6.900]) cube([3.290, 2.810, 0.300]); }  // R_0402-3099_AF0_ASM_ASM
    color("#444") intersection() { cylinder(r = 23.01, h = 20); translate([1.890, -14.070, 6.900]) cube([0.900, 0.500, 0.300]); }  // _7_AF0
    color("#444") intersection() { cylinder(r = 23.01, h = 20); translate([-2.440, -14.070, 6.900]) cube([0.200, 0.500, 0.300]); }  // R_0402-3099_AF0_ASM_ASM
    color("#444") intersection() { cylinder(r = 23.01, h = 20); translate([-3.620, -14.660, 6.900]) cube([3.290, 2.810, 0.300]); }  // R_0402-3099_AF0_ASM_ASM
    color("#444") intersection() { cylinder(r = 23.01, h = 20); translate([-3.190, -14.070, 6.900]) cube([0.900, 0.500, 0.300]); }  // _7_AF0
    color("#444") intersection() { cylinder(r = 23.01, h = 20); translate([-15.750, -7.840, 6.920]) cube([0.330, 0.630, 0.280]); }  // USER_LIBRARY-RES_0603-0201_ASM
    color("#444") intersection() { cylinder(r = 23.01, h = 20); translate([-15.750, -7.860, 6.900]) cube([0.330, 0.100, 0.330]); }  // USER_LIBRARY-RES_0603-0201_ASM
    color("#444") intersection() { cylinder(r = 23.01, h = 20); translate([-15.750, -7.280, 6.900]) cube([0.330, 0.100, 0.330]); }  // USER_LIBRARY-RES_0603-0201_ASM
    color("#444") intersection() { cylinder(r = 23.01, h = 20); translate([-15.750, -7.760, 7.200]) cube([0.330, 0.480, 0.040]); }  // USER_LIBRARY-RES_0603-0201_ASM
    color("#444") intersection() { cylinder(r = 23.01, h = 20); translate([-4.550, -3.090, 6.900]) cube([2.300, 2.440, 1.000]); }  // 1285498160_ASM
    color("#444") intersection() { cylinder(r = 23.01, h = 20); translate([-9.030, 5.560, 6.900]) cube([2.300, 2.440, 1.000]); }  // 1285498160_ASM
    color("#444") intersection() { cylinder(r = 23.01, h = 20); translate([-19.520, -13.080, 7.000]) cube([3.960, 4.240, 1.000]); }  // 1495836704_ASM
    color("#444") intersection() { cylinder(r = 23.01, h = 20); translate([-16.570, -6.340, 6.920]) cube([0.330, 0.630, 0.280]); }  // USER_LIBRARY-RES_0603-0201_ASM
    color("#444") intersection() { cylinder(r = 23.01, h = 20); translate([-16.570, -5.780, 6.900]) cube([0.330, 0.100, 0.330]); }  // USER_LIBRARY-RES_0603-0201_ASM
    color("#444") intersection() { cylinder(r = 23.01, h = 20); translate([-16.570, -6.360, 6.900]) cube([0.330, 0.100, 0.330]); }  // USER_LIBRARY-RES_0603-0201_ASM
    color("#444") intersection() { cylinder(r = 23.01, h = 20); translate([-16.570, -6.260, 7.200]) cube([0.330, 0.480, 0.040]); }  // USER_LIBRARY-RES_0603-0201_ASM
    color("#444") intersection() { cylinder(r = 23.01, h = 20); translate([-13.190, 0.510, 6.920]) cube([0.630, 0.330, 0.280]); }  // USER_LIBRARY-RES_0603-0201_ASM
    color("#444") intersection() { cylinder(r = 23.01, h = 20); translate([-12.640, 0.510, 6.900]) cube([0.100, 0.330, 0.330]); }  // USER_LIBRARY-RES_0603-0201_ASM
    color("#444") intersection() { cylinder(r = 23.01, h = 20); translate([-13.220, 0.510, 6.900]) cube([0.100, 0.330, 0.330]); }  // USER_LIBRARY-RES_0603-0201_ASM
    color("#444") intersection() { cylinder(r = 23.01, h = 20); translate([-13.120, 0.510, 7.200]) cube([0.480, 0.330, 0.040]); }  // USER_LIBRARY-RES_0603-0201_ASM
    color("#444") intersection() { cylinder(r = 23.01, h = 20); translate([14.150, 8.700, 6.920]) cube([0.630, 0.330, 0.280]); }  // USER_LIBRARY-RES_0603-0201_ASM
    color("#444") intersection() { cylinder(r = 23.01, h = 20); translate([14.700, 8.700, 6.900]) cube([0.100, 0.330, 0.330]); }  // USER_LIBRARY-RES_0603-0201_ASM
    color("#444") intersection() { cylinder(r = 23.01, h = 20); translate([14.120, 8.700, 6.900]) cube([0.100, 0.330, 0.330]); }  // USER_LIBRARY-RES_0603-0201_ASM
    color("#444") intersection() { cylinder(r = 23.01, h = 20); translate([14.220, 8.700, 7.200]) cube([0.480, 0.330, 0.040]); }  // USER_LIBRARY-RES_0603-0201_ASM
    color("#444") intersection() { cylinder(r = 23.01, h = 20); translate([12.220, 8.710, 6.920]) cube([0.630, 0.330, 0.280]); }  // USER_LIBRARY-RES_0603-0201_ASM
    color("#444") intersection() { cylinder(r = 23.01, h = 20); translate([12.190, 8.710, 6.900]) cube([0.100, 0.330, 0.330]); }  // USER_LIBRARY-RES_0603-0201_ASM
    color("#444") intersection() { cylinder(r = 23.01, h = 20); translate([12.770, 8.710, 6.900]) cube([0.100, 0.330, 0.330]); }  // USER_LIBRARY-RES_0603-0201_ASM
    color("#444") intersection() { cylinder(r = 23.01, h = 20); translate([12.290, 8.710, 7.200]) cube([0.480, 0.330, 0.040]); }  // USER_LIBRARY-RES_0603-0201_ASM
    color("#444") intersection() { cylinder(r = 23.01, h = 20); translate([12.570, -17.980, 6.920]) cube([0.330, 0.630, 0.280]); }  // USER_LIBRARY-RES_0603-0201_ASM
    color("#444") intersection() { cylinder(r = 23.01, h = 20); translate([12.570, -17.430, 6.900]) cube([0.330, 0.100, 0.330]); }  // USER_LIBRARY-RES_0603-0201_ASM
    color("#444") intersection() { cylinder(r = 23.01, h = 20); translate([12.570, -18.010, 6.900]) cube([0.330, 0.100, 0.330]); }  // USER_LIBRARY-RES_0603-0201_ASM
    color("#444") intersection() { cylinder(r = 23.01, h = 20); translate([12.570, -17.910, 7.200]) cube([0.330, 0.480, 0.040]); }  // USER_LIBRARY-RES_0603-0201_ASM
    color("#444") intersection() { cylinder(r = 23.01, h = 20); translate([12.230, -7.550, 6.920]) cube([0.630, 0.330, 0.280]); }  // USER_LIBRARY-RES_0603-0201_ASM
    color("#444") intersection() { cylinder(r = 23.01, h = 20); translate([12.790, -7.550, 6.900]) cube([0.100, 0.330, 0.330]); }  // USER_LIBRARY-RES_0603-0201_ASM
    color("#444") intersection() { cylinder(r = 23.01, h = 20); translate([12.210, -7.550, 6.900]) cube([0.100, 0.330, 0.330]); }  // USER_LIBRARY-RES_0603-0201_ASM
    color("#444") intersection() { cylinder(r = 23.01, h = 20); translate([12.310, -7.550, 7.200]) cube([0.480, 0.330, 0.040]); }  // USER_LIBRARY-RES_0603-0201_ASM
    color("#444") intersection() { cylinder(r = 23.01, h = 20); translate([10.820, -7.550, 6.920]) cube([0.630, 0.330, 0.280]); }  // USER_LIBRARY-RES_0603-0201_ASM
    color("#444") intersection() { cylinder(r = 23.01, h = 20); translate([10.800, -7.550, 6.900]) cube([0.100, 0.330, 0.330]); }  // USER_LIBRARY-RES_0603-0201_ASM
    color("#444") intersection() { cylinder(r = 23.01, h = 20); translate([11.380, -7.550, 6.900]) cube([0.100, 0.330, 0.330]); }  // USER_LIBRARY-RES_0603-0201_ASM
    color("#444") intersection() { cylinder(r = 23.01, h = 20); translate([10.900, -7.550, 7.200]) cube([0.480, 0.330, 0.040]); }  // USER_LIBRARY-RES_0603-0201_ASM
    color("#444") intersection() { cylinder(r = 23.01, h = 20); translate([15.100, -14.980, 6.920]) cube([0.630, 0.330, 0.280]); }  // USER_LIBRARY-RES_0603-0201_ASM
    color("#444") intersection() { cylinder(r = 23.01, h = 20); translate([15.070, -14.980, 6.900]) cube([0.100, 0.330, 0.330]); }  // USER_LIBRARY-RES_0603-0201_ASM
    color("#444") intersection() { cylinder(r = 23.01, h = 20); translate([15.650, -14.980, 6.900]) cube([0.100, 0.330, 0.330]); }  // USER_LIBRARY-RES_0603-0201_ASM
    color("#444") intersection() { cylinder(r = 23.01, h = 20); translate([15.170, -14.980, 7.200]) cube([0.480, 0.330, 0.040]); }  // USER_LIBRARY-RES_0603-0201_ASM
    color("#444") intersection() { cylinder(r = 23.01, h = 20); translate([-13.190, -0.240, 6.920]) cube([0.630, 0.330, 0.280]); }  // USER_LIBRARY-RES_0603-0201_ASM
    color("#444") intersection() { cylinder(r = 23.01, h = 20); translate([-13.210, -0.240, 6.900]) cube([0.100, 0.330, 0.330]); }  // USER_LIBRARY-RES_0603-0201_ASM
    color("#444") intersection() { cylinder(r = 23.01, h = 20); translate([-12.630, -0.240, 6.900]) cube([0.100, 0.330, 0.330]); }  // USER_LIBRARY-RES_0603-0201_ASM
    color("#444") intersection() { cylinder(r = 23.01, h = 20); translate([-13.110, -0.240, 7.200]) cube([0.480, 0.330, 0.040]); }  // USER_LIBRARY-RES_0603-0201_ASM
    color("#444") intersection() { cylinder(r = 23.01, h = 20); translate([-13.190, -1.050, 6.920]) cube([0.630, 0.330, 0.280]); }  // USER_LIBRARY-RES_0603-0201_ASM
    color("#444") intersection() { cylinder(r = 23.01, h = 20); translate([-13.210, -1.050, 6.900]) cube([0.100, 0.330, 0.330]); }  // USER_LIBRARY-RES_0603-0201_ASM
    color("#444") intersection() { cylinder(r = 23.01, h = 20); translate([-12.630, -1.050, 6.900]) cube([0.100, 0.330, 0.330]); }  // USER_LIBRARY-RES_0603-0201_ASM
    color("#444") intersection() { cylinder(r = 23.01, h = 20); translate([-13.110, -1.050, 7.200]) cube([0.480, 0.330, 0.040]); }  // USER_LIBRARY-RES_0603-0201_ASM
    color("#444") intersection() { cylinder(r = 23.01, h = 20); translate([-4.730, 9.000, 6.920]) cube([0.330, 0.630, 0.280]); }  // USER_LIBRARY-RES_0603-0201_ASM
    color("#444") intersection() { cylinder(r = 23.01, h = 20); translate([-4.730, 9.560, 6.900]) cube([0.330, 0.100, 0.330]); }  // USER_LIBRARY-RES_0603-0201_ASM
    color("#444") intersection() { cylinder(r = 23.01, h = 20); translate([-4.730, 8.980, 6.900]) cube([0.330, 0.100, 0.330]); }  // USER_LIBRARY-RES_0603-0201_ASM
    color("#444") intersection() { cylinder(r = 23.01, h = 20); translate([-4.730, 9.080, 7.200]) cube([0.330, 0.480, 0.040]); }  // USER_LIBRARY-RES_0603-0201_ASM
    color("#444") intersection() { cylinder(r = 23.01, h = 20); translate([-3.880, 9.000, 6.920]) cube([0.330, 0.630, 0.280]); }  // USER_LIBRARY-RES_0603-0201_ASM
    color("#444") intersection() { cylinder(r = 23.01, h = 20); translate([-3.880, 9.560, 6.900]) cube([0.330, 0.100, 0.330]); }  // USER_LIBRARY-RES_0603-0201_ASM
    color("#444") intersection() { cylinder(r = 23.01, h = 20); translate([-3.880, 8.980, 6.900]) cube([0.330, 0.100, 0.330]); }  // USER_LIBRARY-RES_0603-0201_ASM
    color("#444") intersection() { cylinder(r = 23.01, h = 20); translate([-3.880, 9.080, 7.200]) cube([0.330, 0.480, 0.040]); }  // USER_LIBRARY-RES_0603-0201_ASM
    color("#444") intersection() { cylinder(r = 23.01, h = 20); translate([3.920, 13.560, 6.920]) cube([0.330, 0.630, 0.280]); }  // USER_LIBRARY-RES_0603-0201_ASM
    color("#444") intersection() { cylinder(r = 23.01, h = 20); translate([3.920, 14.110, 6.900]) cube([0.330, 0.100, 0.330]); }  // USER_LIBRARY-RES_0603-0201_ASM
    color("#444") intersection() { cylinder(r = 23.01, h = 20); translate([3.920, 13.530, 6.900]) cube([0.330, 0.100, 0.330]); }  // USER_LIBRARY-RES_0603-0201_ASM
    color("#444") intersection() { cylinder(r = 23.01, h = 20); translate([3.920, 13.630, 7.200]) cube([0.330, 0.480, 0.040]); }  // USER_LIBRARY-RES_0603-0201_ASM
    color("#444") intersection() { cylinder(r = 23.01, h = 20); translate([12.220, 9.560, 6.920]) cube([0.630, 0.330, 0.280]); }  // USER_LIBRARY-RES_0603-0201_ASM
    color("#444") intersection() { cylinder(r = 23.01, h = 20); translate([12.770, 9.560, 6.900]) cube([0.100, 0.330, 0.330]); }  // USER_LIBRARY-RES_0603-0201_ASM
    color("#444") intersection() { cylinder(r = 23.01, h = 20); translate([12.190, 9.560, 6.900]) cube([0.100, 0.330, 0.330]); }  // USER_LIBRARY-RES_0603-0201_ASM
    color("#444") intersection() { cylinder(r = 23.01, h = 20); translate([12.290, 9.560, 7.200]) cube([0.480, 0.330, 0.040]); }  // USER_LIBRARY-RES_0603-0201_ASM
    color("#444") intersection() { cylinder(r = 23.01, h = 20); translate([3.920, 12.210, 6.920]) cube([0.330, 0.630, 0.280]); }  // USER_LIBRARY-RES_0603-0201_ASM
    color("#444") intersection() { cylinder(r = 23.01, h = 20); translate([3.920, 12.180, 6.900]) cube([0.330, 0.100, 0.330]); }  // USER_LIBRARY-RES_0603-0201_ASM
    color("#444") intersection() { cylinder(r = 23.01, h = 20); translate([3.920, 12.760, 6.900]) cube([0.330, 0.100, 0.330]); }  // USER_LIBRARY-RES_0603-0201_ASM
    color("#444") intersection() { cylinder(r = 23.01, h = 20); translate([3.920, 12.280, 7.200]) cube([0.330, 0.480, 0.040]); }  // USER_LIBRARY-RES_0603-0201_ASM
    color("#444") intersection() { cylinder(r = 23.01, h = 20); translate([-7.070, 11.290, 6.920]) cube([0.330, 0.630, 0.280]); }  // USER_LIBRARY-RES_0603-0201_ASM
    color("#444") intersection() { cylinder(r = 23.01, h = 20); translate([-7.070, 11.270, 6.900]) cube([0.330, 0.100, 0.330]); }  // USER_LIBRARY-RES_0603-0201_ASM
    color("#444") intersection() { cylinder(r = 23.01, h = 20); translate([-7.070, 11.850, 6.900]) cube([0.330, 0.100, 0.330]); }  // USER_LIBRARY-RES_0603-0201_ASM
    color("#444") intersection() { cylinder(r = 23.01, h = 20); translate([-7.070, 11.370, 7.200]) cube([0.330, 0.480, 0.040]); }  // USER_LIBRARY-RES_0603-0201_ASM
    color("#444") intersection() { cylinder(r = 23.01, h = 20); translate([-4.740, 12.080, 6.920]) cube([0.330, 0.630, 0.280]); }  // USER_LIBRARY-RES_0603-0201_ASM
    color("#444") intersection() { cylinder(r = 23.01, h = 20); translate([-4.740, 12.050, 6.900]) cube([0.330, 0.100, 0.330]); }  // USER_LIBRARY-RES_0603-0201_ASM
    color("#444") intersection() { cylinder(r = 23.01, h = 20); translate([-4.740, 12.630, 6.900]) cube([0.330, 0.100, 0.330]); }  // USER_LIBRARY-RES_0603-0201_ASM
    color("#444") intersection() { cylinder(r = 23.01, h = 20); translate([-4.740, 12.150, 7.200]) cube([0.330, 0.480, 0.040]); }  // USER_LIBRARY-RES_0603-0201_ASM
    color("#444") intersection() { cylinder(r = 23.01, h = 20); translate([0.120, -9.560, 6.920]) cube([0.330, 0.630, 0.280]); }  // USER_LIBRARY-RES_0603-0201_ASM
    color("#444") intersection() { cylinder(r = 23.01, h = 20); translate([0.120, -9.580, 6.900]) cube([0.330, 0.100, 0.330]); }  // USER_LIBRARY-RES_0603-0201_ASM
    color("#444") intersection() { cylinder(r = 23.01, h = 20); translate([0.120, -9.000, 6.900]) cube([0.330, 0.100, 0.330]); }  // USER_LIBRARY-RES_0603-0201_ASM
    color("#444") intersection() { cylinder(r = 23.01, h = 20); translate([0.120, -9.480, 7.200]) cube([0.330, 0.480, 0.040]); }  // USER_LIBRARY-RES_0603-0201_ASM
    color("#444") intersection() { cylinder(r = 23.01, h = 20); translate([-1.500, -9.560, 6.920]) cube([0.330, 0.630, 0.280]); }  // USER_LIBRARY-RES_0603-0201_ASM
    color("#444") intersection() { cylinder(r = 23.01, h = 20); translate([-1.500, -9.580, 6.900]) cube([0.330, 0.100, 0.330]); }  // USER_LIBRARY-RES_0603-0201_ASM
    color("#444") intersection() { cylinder(r = 23.01, h = 20); translate([-1.500, -9.000, 6.900]) cube([0.330, 0.100, 0.330]); }  // USER_LIBRARY-RES_0603-0201_ASM
    color("#444") intersection() { cylinder(r = 23.01, h = 20); translate([-1.500, -9.480, 7.200]) cube([0.330, 0.480, 0.040]); }  // USER_LIBRARY-RES_0603-0201_ASM
    color("#444") intersection() { cylinder(r = 23.01, h = 20); translate([3.730, -9.610, 6.920]) cube([0.330, 0.630, 0.280]); }  // USER_LIBRARY-RES_0603-0201_ASM
    color("#444") intersection() { cylinder(r = 23.01, h = 20); translate([3.730, -9.640, 6.900]) cube([0.330, 0.100, 0.330]); }  // USER_LIBRARY-RES_0603-0201_ASM
    color("#444") intersection() { cylinder(r = 23.01, h = 20); translate([3.730, -9.060, 6.900]) cube([0.330, 0.100, 0.330]); }  // USER_LIBRARY-RES_0603-0201_ASM
    color("#444") intersection() { cylinder(r = 23.01, h = 20); translate([3.730, -9.540, 7.200]) cube([0.330, 0.480, 0.040]); }  // USER_LIBRARY-RES_0603-0201_ASM
    color("#444") intersection() { cylinder(r = 23.01, h = 20); translate([2.840, -9.610, 6.920]) cube([0.330, 0.630, 0.280]); }  // USER_LIBRARY-RES_0603-0201_ASM
    color("#444") intersection() { cylinder(r = 23.01, h = 20); translate([2.840, -9.060, 6.900]) cube([0.330, 0.100, 0.330]); }  // USER_LIBRARY-RES_0603-0201_ASM
    color("#444") intersection() { cylinder(r = 23.01, h = 20); translate([2.840, -9.640, 6.900]) cube([0.330, 0.100, 0.330]); }  // USER_LIBRARY-RES_0603-0201_ASM
    color("#444") intersection() { cylinder(r = 23.01, h = 20); translate([2.840, -9.540, 7.200]) cube([0.330, 0.480, 0.040]); }  // USER_LIBRARY-RES_0603-0201_ASM
    color("#444") intersection() { cylinder(r = 23.01, h = 20); translate([-15.760, -6.320, 6.920]) cube([0.330, 0.630, 0.280]); }  // USER_LIBRARY-RES_0603-0201_ASM
    color("#444") intersection() { cylinder(r = 23.01, h = 20); translate([-15.760, -6.340, 6.900]) cube([0.330, 0.100, 0.330]); }  // USER_LIBRARY-RES_0603-0201_ASM
    color("#444") intersection() { cylinder(r = 23.01, h = 20); translate([-15.760, -5.760, 6.900]) cube([0.330, 0.100, 0.330]); }  // USER_LIBRARY-RES_0603-0201_ASM
    color("#444") intersection() { cylinder(r = 23.01, h = 20); translate([-15.760, -6.240, 7.200]) cube([0.330, 0.480, 0.040]); }  // USER_LIBRARY-RES_0603-0201_ASM
    color("#444") intersection() { cylinder(r = 23.01, h = 20); translate([-5.260, 4.550, 6.900]) cube([3.740, 3.590, 0.400]); }  // R_0603-3601_AF0_ASM_ASM
    color("#444") intersection() { cylinder(r = 23.01, h = 20); translate([-4.390, 5.950, 6.900]) cube([0.800, 1.500, 0.400]); }  // _7_1_2_AF0
    color("#444") intersection() { cylinder(r = 23.01, h = 20); translate([-4.390, 7.250, 6.900]) cube([0.800, 0.250, 0.400]); }  // R_0603-3601_AF0_ASM_ASM
    color("#444") intersection() { cylinder(r = 23.01, h = 20); translate([-8.080, 5.260, 6.900]) cube([3.730, 3.580, 0.400]); }  // R_0603-3601_AF0_ASM_ASM
    color("#444") intersection() { cylinder(r = 23.01, h = 20); translate([-6.020, 5.950, 6.900]) cube([0.800, 1.500, 0.400]); }  // _7_1_2_AF0
    color("#444") intersection() { cylinder(r = 23.01, h = 20); translate([-6.020, 5.900, 6.900]) cube([0.800, 0.250, 0.400]); }  // R_0603-3601_AF0_ASM_ASM
    color("#444") intersection() { cylinder(r = 23.01, h = 20); translate([-7.070, 9.000, 6.920]) cube([0.330, 0.630, 0.280]); }  // USER_LIBRARY-RES_0603-0201_ASM
    color("#444") intersection() { cylinder(r = 23.01, h = 20); translate([-7.070, 8.980, 6.900]) cube([0.330, 0.100, 0.330]); }  // USER_LIBRARY-RES_0603-0201_ASM
    color("#444") intersection() { cylinder(r = 23.01, h = 20); translate([-7.070, 9.560, 6.900]) cube([0.330, 0.100, 0.330]); }  // USER_LIBRARY-RES_0603-0201_ASM
    color("#444") intersection() { cylinder(r = 23.01, h = 20); translate([-7.070, 9.080, 7.200]) cube([0.330, 0.480, 0.040]); }  // USER_LIBRARY-RES_0603-0201_ASM
    color("#444") intersection() { cylinder(r = 23.01, h = 20); translate([-6.890, 7.360, 6.900]) cube([3.730, 3.580, 0.400]); }  // R_0603-3601_AF0_ASM_ASM
    color("#444") intersection() { cylinder(r = 23.01, h = 20); translate([-6.020, 8.750, 6.900]) cube([0.800, 1.500, 0.400]); }  // _7_1_2_AF0
    color("#444") intersection() { cylinder(r = 23.01, h = 20); translate([-6.020, 10.050, 6.900]) cube([0.800, 0.250, 0.400]); }  // R_0603-3601_AF0_ASM_ASM
    color("#444") intersection() { cylinder(r = 23.01, h = 20); translate([-3.800, 1.090, 6.920]) cube([0.630, 0.330, 0.280]); }  // USER_LIBRARY-RES_0603-0201_ASM
    color("#444") intersection() { cylinder(r = 23.01, h = 20); translate([-3.830, 1.090, 6.900]) cube([0.100, 0.330, 0.330]); }  // USER_LIBRARY-RES_0603-0201_ASM
    color("#444") intersection() { cylinder(r = 23.01, h = 20); translate([-3.250, 1.090, 6.900]) cube([0.100, 0.330, 0.330]); }  // USER_LIBRARY-RES_0603-0201_ASM
    color("#444") intersection() { cylinder(r = 23.01, h = 20); translate([-3.730, 1.090, 7.200]) cube([0.480, 0.330, 0.040]); }  // USER_LIBRARY-RES_0603-0201_ASM
    color("#444") intersection() { cylinder(r = 23.01, h = 20); translate([15.100, -15.800, 6.920]) cube([0.630, 0.330, 0.280]); }  // USER_LIBRARY-RES_0603-0201_ASM
    color("#444") intersection() { cylinder(r = 23.01, h = 20); translate([15.070, -15.800, 6.900]) cube([0.100, 0.330, 0.330]); }  // USER_LIBRARY-RES_0603-0201_ASM
    color("#444") intersection() { cylinder(r = 23.01, h = 20); translate([15.650, -15.800, 6.900]) cube([0.100, 0.330, 0.330]); }  // USER_LIBRARY-RES_0603-0201_ASM
    color("#444") intersection() { cylinder(r = 23.01, h = 20); translate([15.170, -15.800, 7.200]) cube([0.480, 0.330, 0.040]); }  // USER_LIBRARY-RES_0603-0201_ASM
    color("#444") intersection() { cylinder(r = 23.01, h = 20); translate([11.380, -16.390, 6.900]) cube([3.000, 3.000, 1.300]); }  // SOT-23
    color("#444") intersection() { cylinder(r = 23.01, h = 20); translate([4.850, -5.270, 6.920]) cube([7.180, 7.180, 0.880]); }  // 1285508272_ASM
    color("#444") intersection() { cylinder(r = 23.01, h = 20); translate([1.960, 1.100, 7.200]) cube([0.200, 0.200, 0.580]); }  // CYLINDER-478886
    color("#444") intersection() { cylinder(r = 23.01, h = 20); translate([-0.290, -1.600, 7.000]) cube([2.650, 3.200, 0.760]); }  // 1495835680_ASM
    color("#444") intersection() { cylinder(r = 23.01, h = 20); translate([5.170, 11.870, 6.950]) cube([2.700, 2.700, 0.450]); }  // 1495836960_ASM
    color("#444") intersection() { cylinder(r = 23.01, h = 20); translate([5.330, 5.320, 7.200]) cube([3.900, 5.100, 1.000]); }  // 1285499440_ASM
    color("#444") intersection() { cylinder(r = 23.01, h = 20); translate([-1.600, -14.960, 6.920]) cube([2.800, 3.300, 0.880]); }  // 1495835552_ASM
    color("#444") intersection() { cylinder(r = 23.01, h = 20); translate([10.450, -10.500, 6.900]) cube([2.900, 2.400, 0.800]); }  // USER_LIBRARY-SM2520-4_ASM
    color("#444") intersection() { cylinder(r = 23.01, h = 20); translate([9.030, 12.220, 6.900]) cube([1.100, 2.000, 0.500]); }  // 1495837472_ASM
    color("#444") intersection() { cylinder(r = 23.01, h = 20); translate([-10.810, -9.760, 6.900]) cube([0.490, 0.310, 0.310]); }  // USER_LIBRARY-0201_0603M__CAP_ASM
    color("#444") intersection() { cylinder(r = 23.01, h = 20); translate([-10.870, -9.760, 6.900]) cube([0.060, 0.310, 0.300]); }  // USER_LIBRARY-0201_0603M__CAP_ASM
    color("#444") intersection() { cylinder(r = 23.01, h = 20); translate([-10.320, -9.760, 6.900]) cube([0.060, 0.310, 0.300]); }  // USER_LIBRARY-0201_0603M__CAP_ASM
    color("#444") intersection() { cylinder(r = 23.01, h = 20); translate([-12.720, -8.790, 6.900]) cube([0.490, 0.310, 0.310]); }  // USER_LIBRARY-0201_0603M__CAP_ASM
    color("#444") intersection() { cylinder(r = 23.01, h = 20); translate([-12.780, -8.790, 6.900]) cube([0.060, 0.310, 0.300]); }  // USER_LIBRARY-0201_0603M__CAP_ASM
    color("#444") intersection() { cylinder(r = 23.01, h = 20); translate([-12.230, -8.790, 6.900]) cube([0.060, 0.310, 0.300]); }  // USER_LIBRARY-0201_0603M__CAP_ASM
    color("#444") intersection() { cylinder(r = 23.01, h = 20); translate([-19.520, 7.570, 6.900]) cube([0.300, 0.490, 0.310]); }  // USER_LIBRARY-0201_0603M__CAP_ASM
    color("#444") intersection() { cylinder(r = 23.01, h = 20); translate([-19.520, 7.510, 6.900]) cube([0.300, 0.060, 0.300]); }  // USER_LIBRARY-0201_0603M__CAP_ASM
    color("#444") intersection() { cylinder(r = 23.01, h = 20); translate([-19.520, 8.060, 6.900]) cube([0.300, 0.060, 0.300]); }  // USER_LIBRARY-0201_0603M__CAP_ASM
    color("#444") intersection() { cylinder(r = 23.01, h = 20); translate([-21.210, 6.230, 6.900]) cube([0.300, 0.490, 0.310]); }  // USER_LIBRARY-0201_0603M__CAP_ASM
    color("#444") intersection() { cylinder(r = 23.01, h = 20); translate([-21.210, 6.170, 6.900]) cube([0.300, 0.060, 0.300]); }  // USER_LIBRARY-0201_0603M__CAP_ASM
    color("#444") intersection() { cylinder(r = 23.01, h = 20); translate([-21.210, 6.720, 6.900]) cube([0.300, 0.060, 0.300]); }  // USER_LIBRARY-0201_0603M__CAP_ASM
    color("#444") intersection() { cylinder(r = 23.01, h = 20); translate([-19.520, 6.270, 6.900]) cube([0.300, 0.490, 0.310]); }  // USER_LIBRARY-0201_0603M__CAP_ASM
    color("#444") intersection() { cylinder(r = 23.01, h = 20); translate([-19.520, 6.760, 6.900]) cube([0.300, 0.060, 0.300]); }  // USER_LIBRARY-0201_0603M__CAP_ASM
    color("#444") intersection() { cylinder(r = 23.01, h = 20); translate([-19.520, 6.210, 6.900]) cube([0.300, 0.060, 0.300]); }  // USER_LIBRARY-0201_0603M__CAP_ASM
    color("#444") intersection() { cylinder(r = 23.01, h = 20); translate([-10.810, -8.790, 6.900]) cube([0.490, 0.310, 0.310]); }  // USER_LIBRARY-0201_0603M__CAP_ASM
    color("#444") intersection() { cylinder(r = 23.01, h = 20); translate([-10.870, -8.790, 6.900]) cube([0.060, 0.310, 0.300]); }  // USER_LIBRARY-0201_0603M__CAP_ASM
    color("#444") intersection() { cylinder(r = 23.01, h = 20); translate([-10.320, -8.790, 6.900]) cube([0.060, 0.310, 0.300]); }  // USER_LIBRARY-0201_0603M__CAP_ASM
    color("#444") intersection() { cylinder(r = 23.01, h = 20); translate([-10.810, -5.880, 6.900]) cube([0.490, 0.300, 0.310]); }  // USER_LIBRARY-0201_0603M__CAP_ASM
    color("#444") intersection() { cylinder(r = 23.01, h = 20); translate([-10.870, -5.880, 6.900]) cube([0.060, 0.300, 0.300]); }  // USER_LIBRARY-0201_0603M__CAP_ASM
    color("#444") intersection() { cylinder(r = 23.01, h = 20); translate([-10.320, -5.880, 6.900]) cube([0.060, 0.300, 0.300]); }  // USER_LIBRARY-0201_0603M__CAP_ASM
    color("#444") intersection() { cylinder(r = 23.01, h = 20); translate([-10.810, -6.850, 6.900]) cube([0.490, 0.300, 0.310]); }  // USER_LIBRARY-0201_0603M__CAP_ASM
    color("#444") intersection() { cylinder(r = 23.01, h = 20); translate([-10.870, -6.850, 6.900]) cube([0.060, 0.300, 0.300]); }  // USER_LIBRARY-0201_0603M__CAP_ASM
    color("#444") intersection() { cylinder(r = 23.01, h = 20); translate([-10.320, -6.850, 6.900]) cube([0.060, 0.300, 0.300]); }  // USER_LIBRARY-0201_0603M__CAP_ASM
    color("#444") intersection() { cylinder(r = 23.01, h = 20); translate([-17.820, 7.570, 6.900]) cube([0.300, 0.490, 0.310]); }  // USER_LIBRARY-0201_0603M__CAP_ASM
    color("#444") intersection() { cylinder(r = 23.01, h = 20); translate([-17.820, 8.060, 6.900]) cube([0.300, 0.060, 0.300]); }  // USER_LIBRARY-0201_0603M__CAP_ASM
    color("#444") intersection() { cylinder(r = 23.01, h = 20); translate([-17.820, 7.510, 6.900]) cube([0.300, 0.060, 0.300]); }  // USER_LIBRARY-0201_0603M__CAP_ASM
    color("#444") intersection() { cylinder(r = 23.01, h = 20); translate([-16.970, 7.570, 6.900]) cube([0.300, 0.490, 0.310]); }  // USER_LIBRARY-0201_0603M__CAP_ASM
    color("#444") intersection() { cylinder(r = 23.01, h = 20); translate([-16.970, 8.060, 6.900]) cube([0.300, 0.060, 0.300]); }  // USER_LIBRARY-0201_0603M__CAP_ASM
    color("#444") intersection() { cylinder(r = 23.01, h = 20); translate([-16.970, 7.510, 6.900]) cube([0.300, 0.060, 0.300]); }  // USER_LIBRARY-0201_0603M__CAP_ASM
    color("#444") intersection() { cylinder(r = 23.01, h = 20); translate([-17.830, 6.270, 6.900]) cube([0.310, 0.490, 0.310]); }  // USER_LIBRARY-0201_0603M__CAP_ASM
    color("#444") intersection() { cylinder(r = 23.01, h = 20); translate([-17.830, 6.210, 6.900]) cube([0.310, 0.060, 0.300]); }  // USER_LIBRARY-0201_0603M__CAP_ASM
    color("#444") intersection() { cylinder(r = 23.01, h = 20); translate([-17.830, 6.760, 6.900]) cube([0.300, 0.060, 0.300]); }  // USER_LIBRARY-0201_0603M__CAP_ASM
    color("#444") intersection() { cylinder(r = 23.01, h = 20); translate([-16.980, 6.240, 6.900]) cube([0.300, 0.490, 0.310]); }  // USER_LIBRARY-0201_0603M__CAP_ASM
    color("#444") intersection() { cylinder(r = 23.01, h = 20); translate([-16.980, 6.180, 6.900]) cube([0.300, 0.060, 0.300]); }  // USER_LIBRARY-0201_0603M__CAP_ASM
    color("#444") intersection() { cylinder(r = 23.01, h = 20); translate([-16.980, 6.730, 6.900]) cube([0.300, 0.060, 0.300]); }  // USER_LIBRARY-0201_0603M__CAP_ASM
    color("#444") intersection() { cylinder(r = 23.01, h = 20); translate([-10.810, -4.920, 6.900]) cube([0.490, 0.310, 0.310]); }  // USER_LIBRARY-0201_0603M__CAP_ASM
    color("#444") intersection() { cylinder(r = 23.01, h = 20); translate([-10.870, -4.920, 6.900]) cube([0.060, 0.310, 0.300]); }  // USER_LIBRARY-0201_0603M__CAP_ASM
    color("#444") intersection() { cylinder(r = 23.01, h = 20); translate([-10.320, -4.920, 6.900]) cube([0.060, 0.310, 0.300]); }  // USER_LIBRARY-0201_0603M__CAP_ASM
    color("#444") intersection() { cylinder(r = 23.01, h = 20); translate([-10.810, -3.950, 6.900]) cube([0.490, 0.310, 0.310]); }  // USER_LIBRARY-0201_0603M__CAP_ASM
    color("#444") intersection() { cylinder(r = 23.01, h = 20); translate([-10.870, -3.950, 6.900]) cube([0.060, 0.310, 0.300]); }  // USER_LIBRARY-0201_0603M__CAP_ASM
    color("#444") intersection() { cylinder(r = 23.01, h = 20); translate([-10.320, -3.950, 6.900]) cube([0.060, 0.310, 0.300]); }  // USER_LIBRARY-0201_0603M__CAP_ASM
    color("#444") intersection() { cylinder(r = 23.01, h = 20); translate([-10.810, -7.820, 6.900]) cube([0.490, 0.310, 0.310]); }  // USER_LIBRARY-0201_0603M__CAP_ASM
    color("#444") intersection() { cylinder(r = 23.01, h = 20); translate([-10.870, -7.820, 6.900]) cube([0.060, 0.310, 0.300]); }  // USER_LIBRARY-0201_0603M__CAP_ASM
    color("#444") intersection() { cylinder(r = 23.01, h = 20); translate([-10.320, -7.820, 6.900]) cube([0.060, 0.310, 0.300]); }  // USER_LIBRARY-0201_0603M__CAP_ASM
    color("#444") intersection() { cylinder(r = 23.01, h = 20); translate([-12.700, -9.760, 6.900]) cube([0.490, 0.310, 0.310]); }  // USER_LIBRARY-0201_0603M__CAP_ASM
    color("#444") intersection() { cylinder(r = 23.01, h = 20); translate([-12.760, -9.760, 6.900]) cube([0.060, 0.310, 0.300]); }  // USER_LIBRARY-0201_0603M__CAP_ASM
    color("#444") intersection() { cylinder(r = 23.01, h = 20); translate([-12.210, -9.760, 6.900]) cube([0.060, 0.310, 0.300]); }  // USER_LIBRARY-0201_0603M__CAP_ASM
    color("#444") intersection() { cylinder(r = 23.01, h = 20); translate([-6.480, -4.260, 6.900]) cube([0.300, 0.490, 0.310]); }  // USER_LIBRARY-0201_0603M__CAP_ASM
    color("#444") intersection() { cylinder(r = 23.01, h = 20); translate([-6.480, -3.770, 6.900]) cube([0.300, 0.060, 0.300]); }  // USER_LIBRARY-0201_0603M__CAP_ASM
    color("#444") intersection() { cylinder(r = 23.01, h = 20); translate([-6.480, -4.320, 6.900]) cube([0.300, 0.060, 0.300]); }  // USER_LIBRARY-0201_0603M__CAP_ASM
    color("#444") intersection() { cylinder(r = 23.01, h = 20); translate([-7.330, -4.260, 6.900]) cube([0.310, 0.490, 0.310]); }  // USER_LIBRARY-0201_0603M__CAP_ASM
    color("#444") intersection() { cylinder(r = 23.01, h = 20); translate([-7.330, -3.770, 6.900]) cube([0.310, 0.060, 0.300]); }  // USER_LIBRARY-0201_0603M__CAP_ASM
    color("#444") intersection() { cylinder(r = 23.01, h = 20); translate([-7.330, -4.320, 6.900]) cube([0.310, 0.060, 0.300]); }  // USER_LIBRARY-0201_0603M__CAP_ASM
    color("#444") intersection() { cylinder(r = 23.01, h = 20); translate([-4.800, -4.260, 6.900]) cube([0.310, 0.490, 0.310]); }  // USER_LIBRARY-0201_0603M__CAP_ASM
    color("#444") intersection() { cylinder(r = 23.01, h = 20); translate([-4.800, -3.770, 6.900]) cube([0.310, 0.060, 0.300]); }  // USER_LIBRARY-0201_0603M__CAP_ASM
    color("#444") intersection() { cylinder(r = 23.01, h = 20); translate([-4.800, -4.320, 6.900]) cube([0.310, 0.060, 0.300]); }  // USER_LIBRARY-0201_0603M__CAP_ASM
    color("#444") intersection() { cylinder(r = 23.01, h = 20); translate([-5.640, -4.260, 6.900]) cube([0.300, 0.490, 0.310]); }  // USER_LIBRARY-0201_0603M__CAP_ASM
    color("#444") intersection() { cylinder(r = 23.01, h = 20); translate([-5.640, -3.770, 6.900]) cube([0.300, 0.060, 0.300]); }  // USER_LIBRARY-0201_0603M__CAP_ASM
    color("#444") intersection() { cylinder(r = 23.01, h = 20); translate([-5.640, -4.320, 6.900]) cube([0.300, 0.060, 0.300]); }  // USER_LIBRARY-0201_0603M__CAP_ASM
    color("#444") intersection() { cylinder(r = 23.01, h = 20); translate([-8.170, -4.260, 6.900]) cube([0.310, 0.490, 0.310]); }  // USER_LIBRARY-0201_0603M__CAP_ASM
    color("#444") intersection() { cylinder(r = 23.01, h = 20); translate([-8.170, -3.770, 6.900]) cube([0.310, 0.060, 0.300]); }  // USER_LIBRARY-0201_0603M__CAP_ASM
    color("#444") intersection() { cylinder(r = 23.01, h = 20); translate([-8.170, -4.320, 6.900]) cube([0.310, 0.060, 0.300]); }  // USER_LIBRARY-0201_0603M__CAP_ASM
    color("#444") intersection() { cylinder(r = 23.01, h = 20); translate([-9.010, -4.260, 6.900]) cube([0.310, 0.490, 0.310]); }  // USER_LIBRARY-0201_0603M__CAP_ASM
    color("#444") intersection() { cylinder(r = 23.01, h = 20); translate([-9.010, -3.770, 6.900]) cube([0.310, 0.060, 0.300]); }  // USER_LIBRARY-0201_0603M__CAP_ASM
    color("#444") intersection() { cylinder(r = 23.01, h = 20); translate([-9.010, -4.320, 6.900]) cube([0.310, 0.060, 0.300]); }  // USER_LIBRARY-0201_0603M__CAP_ASM
    color("#444") intersection() { cylinder(r = 23.01, h = 20); translate([-3.480, -4.580, 6.900]) cube([0.490, 0.310, 0.310]); }  // USER_LIBRARY-0201_0603M__CAP_ASM
    color("#444") intersection() { cylinder(r = 23.01, h = 20); translate([-3.540, -4.580, 6.900]) cube([0.060, 0.310, 0.300]); }  // USER_LIBRARY-0201_0603M__CAP_ASM
    color("#444") intersection() { cylinder(r = 23.01, h = 20); translate([-2.990, -4.580, 6.900]) cube([0.060, 0.310, 0.300]); }  // USER_LIBRARY-0201_0603M__CAP_ASM
    color("#444") intersection() { cylinder(r = 23.01, h = 20); translate([-3.480, -9.760, 6.900]) cube([0.490, 0.310, 0.310]); }  // USER_LIBRARY-0201_0603M__CAP_ASM
    color("#444") intersection() { cylinder(r = 23.01, h = 20); translate([-3.540, -9.760, 6.900]) cube([0.060, 0.310, 0.300]); }  // USER_LIBRARY-0201_0603M__CAP_ASM
    color("#444") intersection() { cylinder(r = 23.01, h = 20); translate([-2.990, -9.760, 6.900]) cube([0.060, 0.310, 0.300]); }  // USER_LIBRARY-0201_0603M__CAP_ASM
    color("#444") intersection() { cylinder(r = 23.01, h = 20); translate([-3.480, -8.890, 6.900]) cube([0.490, 0.300, 0.310]); }  // USER_LIBRARY-0201_0603M__CAP_ASM
    color("#444") intersection() { cylinder(r = 23.01, h = 20); translate([-3.540, -8.890, 6.900]) cube([0.060, 0.300, 0.300]); }  // USER_LIBRARY-0201_0603M__CAP_ASM
    color("#444") intersection() { cylinder(r = 23.01, h = 20); translate([-2.990, -8.890, 6.900]) cube([0.060, 0.300, 0.300]); }  // USER_LIBRARY-0201_0603M__CAP_ASM
    color("#444") intersection() { cylinder(r = 23.01, h = 20); translate([-3.480, -8.030, 6.900]) cube([0.490, 0.310, 0.310]); }  // USER_LIBRARY-0201_0603M__CAP_ASM
    color("#444") intersection() { cylinder(r = 23.01, h = 20); translate([-3.540, -8.030, 6.900]) cube([0.060, 0.310, 0.300]); }  // USER_LIBRARY-0201_0603M__CAP_ASM
    color("#444") intersection() { cylinder(r = 23.01, h = 20); translate([-2.990, -8.030, 6.900]) cube([0.060, 0.310, 0.300]); }  // USER_LIBRARY-0201_0603M__CAP_ASM
    color("#444") intersection() { cylinder(r = 23.01, h = 20); translate([-3.480, -5.440, 6.900]) cube([0.490, 0.310, 0.310]); }  // USER_LIBRARY-0201_0603M__CAP_ASM
    color("#444") intersection() { cylinder(r = 23.01, h = 20); translate([-3.540, -5.440, 6.900]) cube([0.060, 0.310, 0.300]); }  // USER_LIBRARY-0201_0603M__CAP_ASM
    color("#444") intersection() { cylinder(r = 23.01, h = 20); translate([-2.990, -5.440, 6.900]) cube([0.060, 0.310, 0.300]); }  // USER_LIBRARY-0201_0603M__CAP_ASM
    color("#444") intersection() { cylinder(r = 23.01, h = 20); translate([-3.480, -6.300, 6.900]) cube([0.490, 0.300, 0.310]); }  // USER_LIBRARY-0201_0603M__CAP_ASM
    color("#444") intersection() { cylinder(r = 23.01, h = 20); translate([-3.540, -6.300, 6.900]) cube([0.060, 0.300, 0.300]); }  // USER_LIBRARY-0201_0603M__CAP_ASM
    color("#444") intersection() { cylinder(r = 23.01, h = 20); translate([-2.990, -6.300, 6.900]) cube([0.060, 0.300, 0.300]); }  // USER_LIBRARY-0201_0603M__CAP_ASM
    color("#444") intersection() { cylinder(r = 23.01, h = 20); translate([-3.480, -7.170, 6.900]) cube([0.490, 0.310, 0.310]); }  // USER_LIBRARY-0201_0603M__CAP_ASM
    color("#444") intersection() { cylinder(r = 23.01, h = 20); translate([-3.540, -7.170, 6.900]) cube([0.060, 0.310, 0.300]); }  // USER_LIBRARY-0201_0603M__CAP_ASM
    color("#444") intersection() { cylinder(r = 23.01, h = 20); translate([-2.990, -7.170, 6.900]) cube([0.060, 0.310, 0.300]); }  // USER_LIBRARY-0201_0603M__CAP_ASM
    color("#444") intersection() { cylinder(r = 23.01, h = 20); translate([-20.380, 6.190, 6.920]) cube([0.330, 0.630, 0.280]); }  // USER_LIBRARY-RES_0603-0201_ASM
    color("#444") intersection() { cylinder(r = 23.01, h = 20); translate([-20.380, 6.750, 6.900]) cube([0.330, 0.100, 0.330]); }  // USER_LIBRARY-RES_0603-0201_ASM
    color("#444") intersection() { cylinder(r = 23.01, h = 20); translate([-20.380, 6.170, 6.900]) cube([0.330, 0.100, 0.330]); }  // USER_LIBRARY-RES_0603-0201_ASM
    color("#444") intersection() { cylinder(r = 23.01, h = 20); translate([-20.380, 6.270, 7.200]) cube([0.330, 0.480, 0.040]); }  // USER_LIBRARY-RES_0603-0201_ASM
    color("#444") intersection() { cylinder(r = 23.01, h = 20); translate([-19.390, 9.600, 7.000]) cube([4.080, 4.280, 1.000]); }  // 1495836576_ASM
    color("#444") intersection() { cylinder(r = 23.01, h = 20); translate([16.750, -2.360, 6.920]) cube([0.630, 0.330, 0.280]); }  // USER_LIBRARY-RES_0603-0201_ASM
    color("#444") intersection() { cylinder(r = 23.01, h = 20); translate([16.730, -2.360, 6.900]) cube([0.100, 0.330, 0.330]); }  // USER_LIBRARY-RES_0603-0201_ASM
    color("#444") intersection() { cylinder(r = 23.01, h = 20); translate([17.310, -2.360, 6.900]) cube([0.100, 0.330, 0.330]); }  // USER_LIBRARY-RES_0603-0201_ASM
    color("#444") intersection() { cylinder(r = 23.01, h = 20); translate([16.830, -2.360, 7.200]) cube([0.480, 0.330, 0.040]); }  // USER_LIBRARY-RES_0603-0201_ASM
    color("#444") intersection() { cylinder(r = 23.01, h = 20); translate([-12.160, -11.940, 6.900]) cube([0.200, 0.500, 0.300]); }  // R_0402-3099_AF0_ASM_ASM
    color("#444") intersection() { cylinder(r = 23.01, h = 20); translate([-13.340, -12.530, 6.900]) cube([3.300, 2.800, 0.300]); }  // R_0402-3099_AF0_ASM_ASM
    color("#444") intersection() { cylinder(r = 23.01, h = 20); translate([-12.910, -11.940, 6.900]) cube([0.900, 0.500, 0.300]); }  // _7_AF0
    color("#444") intersection() { cylinder(r = 23.01, h = 20); translate([-12.160, -12.960, 6.900]) cube([0.200, 0.500, 0.300]); }  // R_0402-3099_AF0_ASM_ASM
    color("#444") intersection() { cylinder(r = 23.01, h = 20); translate([-13.330, -13.550, 6.900]) cube([3.290, 2.810, 0.300]); }  // R_0402-3099_AF0_ASM_ASM
    color("#444") intersection() { cylinder(r = 23.01, h = 20); translate([-12.910, -12.960, 6.900]) cube([0.900, 0.500, 0.300]); }  // _7_AF0
    color("#444") intersection() { cylinder(r = 23.01, h = 20); translate([-12.960, -10.930, 6.900]) cube([0.200, 0.500, 0.300]); }  // R_0402-3099_AF0_ASM_ASM
    color("#444") intersection() { cylinder(r = 23.01, h = 20); translate([-14.870, -12.650, 6.900]) cube([3.290, 2.810, 0.300]); }  // R_0402-3099_AF0_ASM_ASM
    color("#444") intersection() { cylinder(r = 23.01, h = 20); translate([-12.910, -10.930, 6.900]) cube([0.900, 0.500, 0.300]); }  // _7_AF0
    color("#444") intersection() { cylinder(r = 23.01, h = 20); translate([-12.960, -13.970, 6.900]) cube([0.200, 0.500, 0.300]); }  // R_0402-3099_AF0_ASM_ASM
    color("#444") intersection() { cylinder(r = 23.01, h = 20); translate([-14.870, -15.690, 6.900]) cube([3.290, 2.810, 0.300]); }  // R_0402-3099_AF0_ASM_ASM
    color("#444") intersection() { cylinder(r = 23.01, h = 20); translate([-12.910, -13.970, 6.900]) cube([0.900, 0.500, 0.300]); }  // _7_AF0
    color("#444") intersection() { cylinder(r = 23.01, h = 20); translate([12.980, 2.870, 6.900]) cube([3.100, 3.000, 1.250]); }  // J4_ASM
    color("#444") intersection() { cylinder(r = 23.01, h = 20); translate([-8.860, -9.460, 6.920]) cube([4.080, 4.090, 0.880]); }  // 1495836448_ASM
    color("#444") intersection() { cylinder(r = 23.01, h = 20); translate([-7.900, 11.340, 6.900]) cube([0.300, 0.480, 0.310]); }  // USER_LIBRARY-0201_0603M__CAP_ASM
    color("#444") intersection() { cylinder(r = 23.01, h = 20); translate([-7.900, 11.280, 6.900]) cube([0.300, 0.060, 0.300]); }  // USER_LIBRARY-0201_0603M__CAP_ASM
    color("#444") intersection() { cylinder(r = 23.01, h = 20); translate([-7.900, 11.820, 6.900]) cube([0.300, 0.070, 0.300]); }  // USER_LIBRARY-0201_0603M__CAP_ASM
    color("#c9a227") translate([13.750, 14.700, 6.900]) difference() { cylinder(d = 3.5, h = 3.500); translate([0, 0, -1]) cylinder(d = 2, h = 10); }  // SMTSO-M2-3_5ET
    color("#c9a227") translate([0.000, -20.500, 6.900]) difference() { cylinder(d = 3.5, h = 3.500); translate([0, 0, -1]) cylinder(d = 2, h = 10); }  // SMTSO-M2-3_5ET
    color("#c9a227") translate([-13.750, 14.700, 6.900]) difference() { cylinder(d = 3.5, h = 3.500); translate([0, 0, -1]) cylinder(d = 2, h = 10); }  // SMTSO-M2-3_5ET
    color("#444") intersection() { cylinder(r = 23.01, h = 20); translate([-10.430, 17.480, 6.900]) cube([20.850, 2.400, 5.800]); }  // FEMALE-2_54MM-H6-1X8P-V
    color("#999") intersection() { translate([7.01, -13.10, 3.85]) cube([16.26, 25.8, 1.85]); cylinder(r = 23.27, h = 10); }  // micro SD socket
}
