niklaswa/monav-display/firmware/src/core/frame.h

#pragma once

// Everything one frame shows. The app fills it every frame from its state; the renderer draws
// it and depends on nothing else, which is what lets the host build render the same screens to
// PNG.

#include <cstdint>

#include "core/model.h"
#include "core/strings.h"
#include "core/timesync.h"

namespace monav {

enum class Screen : uint8_t { Boot, Waiting, Paired, Denied, Connected, Drive, Standby };

struct MapImage;   // core/mapdata.h
struct RouteLine;

/** What the bottom of the drive HUD shows, in priority order. */
enum class Card : uint8_t { None, Camera, Section, Light, Turn };

struct Frame {
  Screen screen = Screen::Boot;
  Lang lang = Lang::De;
  float t = 0;          // seconds since boot: looping animations
  float screenAge = 0;  // seconds since this screen appeared: entry animations

  char id[5] = "0000";
  bool paired = false;

  bool hasClock = false;
  ClockTime clock;

  // --- Drive HUD ---
  Layout layout = Layout::Hud;
  bool focus = false;     // speed + limit only, bigger (layout == Focus)
  bool tilt = true;       // map in perspective
  float speed = 0;        // km/h, eased towards the latest `v`
  int limit = 0;          // 0 = none known
  float scaleMax = 100;   // km/h at the end of the ring (eased when the limit changes)
  bool linkLost = false;  // no `v` for > 3 s or disconnected mid-drive
  float alert = 0;        // 0..1: camera close and too fast — the ring pulses red

  Card primary = Card::None;
  Card secondary = Card::None;
  Scene scene;            // the parts as last received
  float lightD = 0;       // distances run down since Scene::at
  float camD = 0;
  float turnD = 0;
  float lightLeft = -1;   // seconds until the light's phase ends; −1 = not in the forecast
  float lightPhase = -1;  // fraction of the phase still to go (1 → 0); −1 = unknown
  bool hasEta = false;
  ClockTime eta;

  // --- Map (layout == Map) ---
  bool hasPose = false;   // the car's place from `v`, run on and eased (core/nav)
  double lat = 0, lon = 0;
  float hdg = 0;
  /** Filled in by the caller (the map buffers belong to the device / preview, not the app). */
  const MapImage* map = nullptr;
  const RouteLine* route = nullptr;
  /** Charging stations as pins on the map (`chg`). */
  Chargers chargers;

  // --- Firmware update (filled in by the caller from the OTA writer; takes over the glass) ---
  struct Update {
    enum class Phase : uint8_t { None, Receiving, Verifying, Restarting, Failed };
    Phase phase = Phase::None;
    float progress = 0;  // 0..1
    char version[24] = {0};
    char error[40] = {0};
  } update;

  // --- Overlays ---
  float hold = 0;           // finger resting: 0..1 towards the 3 s reset question
  bool resetAsk = false;    // "Kopplung zurücksetzen? Tippen zum Bestätigen"
  float resetLeft = 0;      // 1 → 0 over the question's timeout
  float brightnessShow = 0; // brightness overlay opacity (while swiping)
  int brightness = 80;      // 5..100
  float toast = 0;          // opacity of a short message at the bottom
  Str toastText = Str::ResetDone;
};

}  // namespace monav
