niklaswa/monav-display/firmware/src/device/bench.h

#pragma once

// Development only (MONAV_DEMO): times the drawing primitives one by one on the board and logs
// them, so optimisations go where the time is.

namespace monav::device::bench {

void run();

}  // namespace monav::device::bench
